jaken31/effente/device/app/README.md

# The effente device app (Arduino UNO Q)

One Arduino App Lab app: the sketch runs on the microcontroller, and the Python side runs our intake, model and stream on the board's Linux side.

```
plug in ──> DISPLAY ──button──> RECORDING ──button──> TRAINING ──done──> WATCHING ──button──> RECORDING ...
            readings              learning              on the board      checking for faults
            ↑ the whole time: readings and status on the OLED, and a live stream on port 8765 ↑
```

| Mode | Screen | What happens |
|---|---|---|
| Streaming | `STREAMING` and the time, vibration, peak, speed, temperature | Sensors are read and features computed; nothing is kept |
| Recording | `RECORDING` and the readings | Learn mode: feature rows, per-minute summaries, raw snippets and events go to `data/recordings/rec-…` |
| Training | `TRAINING`, then the percentage and stage | The model is trained on the board ([effente/trainer.py](../../effente/trainer.py), NumPy only). A recording shorter than 5 minutes is refused, and learning carries on. A day or more trains from the per-minute summaries, so a week fits in memory |
| Inference | `NOTHING WRONG`, or what is wrong (`UNBALANCE LIKE`, `OUTSIDE NORMAL`, …) and the reading that moved most | Judges every summary period: 1 s after a short recording, up to a minute after a long one |

Pressing the button while in inference starts a new recording, to relearn. Recording happens only in the recording mode, and only a button press starts it. After a power cut:

- **Inference:** it carries on with the saved model.
- **Training:** it carries on training. If training then fails, it goes back to not recording, not to recording.
- **Recording:** the recording stops. What was kept stays in its folder, and the app comes back not recording: inference with the saved model if there is one, otherwise streaming. The status message says `power cut ended the recording; press to record again`. The next press starts a new recording.

## What counts as wrong

The device answers two things only: is something wrong, and what. There are no severity levels. "What" is a plain description of what is going on (VIBRATION TOO HIGH, UNUSUAL VIBRATION, KNOCKING OR JOLTS, RAPID TEMP CHANGES, …), not a guess at the cause. The description comes straight from which groups of readings left normal (vibration level, vibration shape, spikiness, speed, temperature, sound, …). On 20 real bearings, the cause guesses were mostly wrong, but the descriptions were accurate for all 35 faults caught ([OTTAWA_RESULTS.md](../../training/record/datasets/OTTAWA_RESULTS.md)). The specific fault type still goes out in the data (`details`, `diagnosis`) for the team. Problems show on the screen as `! …` lines in every mode, go out on the stream as `problem` and `problem_cleared` events, and appear in `/latest` status as `wrong`, `what` and `problems`. The rules are in [effente/safety.py](../../effente/safety.py).

- **The sensor itself, first:** `SENSOR PROBLEM` when the readings make no sense. That means gravity far from 1 g (outside 0.85–1.15 g), no noise at all on any axis (stuck or disconnected), or an IMU temperature outside its rated −40 to 125 °C. While it's on, the vibration checks and the model's diagnosis are set aside, because they would only be judging bad data. On 12 Nov, corrupted samples made the device say VIBRATION TOO HIGH while it sat still; now that case says SENSOR PROBLEM. Learning on such data gives a training note. Sensors that remove gravity by design (industrial piezo sensors) skip the gravity test: their data source sets `accel_measures_gravity = False`.
- **From the moment it's plugged in (no setup, any machine):**
  - vibration over 11 mm/s
  - knocking: impulsive vibration with peaks of 0.5 g or more
  - over 100 °C
  - heating more than 8 °C a minute
  - 5 or more sudden jolts in 10 minutes
- **After training, against this machine's own normal** (the highest while learning): vibration at 2× normal, 15 °C or 6 dB over normal, and the learned model's line. No one has to say what kind of machine it is.
- Each check must hold for 10 seconds before it shows, so a bump doesn't count.
- **Notes after training:** the screen shows notes for 2 minutes after training (status keeps them) if the machine was mostly stopped, hardly vibrated, or was still warming up or changing. Notes also flag a universal limit the machine was already over while learning. That limit is then dropped for this machine, so it doesn't show for ever.

**Sensitivity:** how far outside normal counts as wrong hasn't been decided. Sensitivity goes from 0 (least sensitive) to 1 (most), and the numbers above are the starting values at the default, 0.5. Each 0.25 step halves or doubles how far outside normal counts:

| Sensitivity | Vibration | Temperature | Sound | Model's line |
|---|---|---|---|---|
| 0 | 5× normal | +60 °C | +24 dB | 4× |
| 0.25 | 3× | +30 °C | +12 dB | 2× |
| 0.5 (default) | 2× | +15 °C | +6 dB | 1× |
| 0.75 | 1.5× | +7.5 °C | +3 dB | 0.5× |
| 1 | 1.25× | +3.75 °C | +1.5 dB | 0.25× |

It changes the outside-normal checks and the model, never the universal limits. Change it while the device runs:

```bash
curl -X POST -d '{"sensitivity": 0.7}' http://localhost:8765/settings
```

`curl http://localhost:8765/settings` shows the current value and what it means in numbers. Editing `data/settings.json` on the board (`{"sensitivity": 0.7}`) works too, and is picked up within 2 seconds.

## Early warning

In inference, while nothing is wrong, the device also looks for a small change that has lasted or is creeping up, before it is big enough to count as wrong ([effente/early_warning.py](../../effente/early_warning.py)). It watches each group of readings (the same groups the descriptions come from) and the model's score, against this machine's normal given the other readings, in blocks of 60 summary periods: an hour after a long recording, a minute after a short one. Stopped time is skipped.

- **Screen:** while nothing is wrong, the header's left side reads like `EARLY: HEATING UP` instead of the mode.
- **Stream:** an `early_warning` event (`text`: `TOO HOT CREEPING UP` or `TOO HOT SLIGHTLY UP`, plus `symptom`, `rising` and a coarse `speed`: "rising over hours" or "over days"). An `early_warning_cleared` event follows when it goes away.
- **Status:** `/latest` has an `early_warning` field (`on`, `symptom`, `text`, `since`, …).

It never counts as wrong: `wrong` stays false. While something is wrong it is set aside, it starts again after relearning, and it clears when the change goes away. There's no countdown and no predicted failure time. Sensitivity scales it too. Its normal is saved beside the model (`models/<name>.early.json`). Models trained before it existed have none, so early warning stays off until the machine is relearned. How it compares with other approaches on the simulated conveyor: [EARLY_WARNING.md](../../training/record/conveyor_eval/EARLY_WARNING.md).

## Wiring

| Part | Where | Notes |
|---|---|---|
| MPU6050 (on this board's module: an MPU-6500, WHO_AM_I 0x70) | Third I2C bus (`Wire2`), address 0x68 | Accelerometer ±8 g, gyro ±250 °/s, 1 kHz. Accelerometer low-pass 218 Hz (6500) or 184 Hz (6050) |
| OLED 128×64 | `Wire2`, address 0x3C | SSD1306/SSD1309. For an SH1106, set `OLED_COL_OFFSET` to 2 in the sketch |
| Button | D9 to GND | Internal pull-up, debounced. Until it's wired, `adb shell touch /home/arduino/ArduinoApps/effente/data/press` counts as a press |
| Microphone INMP441, through an ESP32-S3-N16R8 (screen only so far) | Mic to ESP32: VDD 3V3, GND, L/R to GND, SCK GPIO 5, WS GPIO 4, SD GPIO 6. ESP32 to UNO Q: GPIO 17 (TX) to D0, GPIO 18 (RX) to D1 (optional), GND to GND | The ESP32 ([firmware/esp32_mic](../../firmware/esp32_mic/esp32_mic.ino), a test version) sends a text line 4 times a second at 115200 baud: level, peak and a rough strongest tone. On the UNO Q, D0/D1 are `Serial1` (`Serial` is the Bridge's monitor). Measured 13 Nov: 4 lines a second arrive, none missing. The screen shows the level as dBFS + 120 (the datasheet's conversion; not checked against a sound meter, unverified) and the tone. Nothing of it reaches the Linux side as a feature yet: `sound_db` stays empty, and what is sent for sound is still to be agreed by the team. The raw-audio slot is unchanged: the Linux side takes an `audio` notification, but no sketch sends one. Off unless `EFFENTE_MIC=1`. Raw 16 kHz audio won't fit on the Bridge line (see below) |
| Thermal camera MLX90640-D55 (not fitted yet) | I2C, address 0x33, bus not chosen | Slot only: the Linux side takes a `thermal` notification (24 × 32, hundredths of a °C) and the status has `thermal_max_c`, but no sketch reads the camera yet. Off unless `EFFENTE_THERMAL=1` |

## Deploy, and connect to the stream

**Starting at power-up:** on 13 Nov effente was set as the board's default app, so it starts by itself when the board is plugged in:

```bash
adb shell arduino-app-cli properties set default user:effente
```

To stop that, set the default to `none`. Whether it starts reliably at every power-up is untested.

From the repo root, with the board on USB:

```bash
device/app/deploy.sh
```

```bash
adb forward tcp:8765 tcp:8765
```

```bash
curl -N http://localhost:8765/stream
```

`/settings` is described above. `/latest`, `/features` and `/health` are described in [device/intake/README.md](../intake/README.md). On a network that lets devices see each other, use the board's address instead of `localhost`. University WiFi usually doesn't allow that, so use the USB forward or a phone hotspot.

Data stays on the board in `~/ArduinoApps/effente/data`: `recordings/`, `models/`, `state.json`, `settings.json` and `history.npz`. The deploy script never touches it.

## The fan test

This tests the whole device. Fix it to a desk fan and let it learn the fan's normal. Then tape a coin to one blade and see whether it says something is wrong and describes it as a vibration problem. [fan_test.py](fan_test.py) runs on the laptop and guides you through it.

You need:

- the board on USB, with the app deployed (`device/app/deploy.sh`)
- a desk fan
- a coin and some tape
- about 45 minutes

```bash
python3 device/app/fan_test.py
```

The script sets up `adb forward tcp:8765 tcp:8765` itself, then:

1. checks the app is up (`/health`, `/latest`) and prints the sensitivity (`GET /settings`)
2. asks you to fix the device to the fan and switch it on, then presses the button (`adb shell touch …/data/press`) to start learning
3. waits `--minutes` (default 20), showing how long it has learned. Leave the fan running.
4. presses again to train and shows training progress until the device is in inference
5. watches `--normal-minutes` (default 10) with the fan as it is. Anything wrong now is a false alarm.
6. asks you to switch the fan off, tape the coin near the tip of one blade and switch it back on. It then watches up to `--fault-minutes` (default 10). It reports whether the device said something is wrong, what it named, and how long that took. It stops 30 s (`--settle`) after the vibration is described.
7. optionally tries another sensitivity with the coin still on: `--try-sensitivity 0.7`, or type a value when asked. It watches for `--sensitivity-minutes` (default 5), then puts the old sensitivity back.
8. writes a JSON report to `data/fan-test-<time>.json`. Like all of `data/`, it is never committed.

The test passes if there were no false alarms and the coin was described as UNUSUAL VIBRATION or VIBRATION TOO HIGH (`unusual_vibration` or `vibration_too_high` in `what`). The report also says whether the guessed cause was unbalance (`unbalance_like` in `details` or `diagnosis_detail`, which the platform contract calls `imbalance`), for information only. "Wrong" is the device's own `wrong`, in a results line or in status. It covers the model and the no-setup limits (vibration over 11 mm/s, …), so a false alarm from either counts. The exit code is 0 for a pass and 1 otherwise.

Other options:

- `--url` for a board reached over the network, with `--no-forward`
- `--press-cmd "…"` for another way to press the button
- `--poll` for how often status is checked
- `--yes` to skip the Enter prompts

It is tested without hardware, against a local `DeviceApp` fed simulated conveyor data (`python3 -m device.intake.tests.test_fan_test`). **It hasn't been run on the board or a real fan yet.**

## Send to the laptop platform

Set `EFFENTE_PLATFORM_URL` in the app's environment to the laptop's address on the hotspot, for example `http://192.168.43.10:8000` (`python3 platform/run.py --no-sim` prints it). The app then sends its model, a record a second while in inference, and a check-in otherwise, as in [platform/CONTRACT.md](../../platform/CONTRACT.md). Unset, nothing is sent. The start-up line in the app's log says which. Details are in [device/intake/README.md](../intake/README.md#sending-to-the-laptop-platform).

How App Lab passes environment variables to the Python side hasn't been tried yet, and neither has uploading from the board itself.

## Measured on this board (12 Nov 2026)

| | |
|--|--|
| Sample rate | 1,000 a second (998–1,002 by the microcontroller's clock), 0 lost, 0 FIFO overflows |
| Bridge line | 115200 baud, about 11.5 kB/s. The sensor stream uses 7.5 kB/s (65 %). At 1,445 samples a second (the MPU-6500's rate with the old settings) the line was full, and the router logged corrupted packets |
| At rest | 1.018 g; noise 4–9 mg rms (the MPU's own noise) |
| IMU temperature | About 28 °C on a desk (13 Nov), from the IMU's own temperature sensor, sent with every batch, and used as the heat reading when there's no thermal camera. Until 13 Nov it read about 43 °C, because the MPU-6050's conversion was used for our MPU-6500. The 6500's is raw / 333.87 + 21 |
| Features per window | 29 ms with every sensor (12 % of one core at 4 windows a second); less with only the IMU |
| Model | Loads in 8 ms, judges in 6 ms |
| OLED | 10 frames a second, drawn one eighth of the screen per pass at 400 kHz. Drawing the whole frame at once held the bus for about 27 ms; with the sensor read on top, that overflowed the MPU-6500's 512-byte FIFO, which corrupted every later sample (2 g of "vibration" at rest). Running the bus at 1 MHz didn't help. Text from the Linux side costs about 180 bytes of Bridge line per update |
| After the fix (12 Nov, after the reflash) | At rest: 1.018 g gravity, 2–4 mg noise per axis, 0.3–0.5 mm/s. About one FIFO restart every 5 s remains (about 0.7 % of samples, rate 993 a second); the cause isn't found yet |

## Limits and known issues

- **What the Bridge can carry:** the accelerometer at 1 kHz plus the gyro at 100 Hz fits. The microphone (16 kHz) and the thermal camera won't fit raw on the 115200-baud line. Options:
  - process them on the microcontroller
  - connect the mic to the Linux side
  - raise the router's baud rate (a system service change that needs `sudo`; untested)
- **After reflashing the board:** check `systemctl status arduino-burn-bootloader`. On 12 Nov its first-boot run timed out, so the sketch never started (0 samples). Running `arduino-cli burn-bootloader -b arduino:zephyr:unoq -P jlink` on the board fixed it. The newer toolchain also no longer links `log10f` (missing `__errno`), so the sketch uses its own.
- **Startup:** now and then, when the app starts, the sketch doesn't start on the microcontroller: no samples, and the screen frozen. Starting the app again has always fixed it. `deploy.sh` now waits for samples after each start and retries up to 3 times by itself; if all 3 fail, unplug the board for a few seconds. To tell what state it's in, the sketch sends a heartbeat each second: alive, sensor and screen found, WHO_AM_I, and the bus lines' levels. The app logs it every 10 s as `microcontroller: ...`, and "no heartbeat yet" means the sketch isn't running. At every start the sketch also frees the I2C bus (clock pulses on A5, then a STOP), in case a reset caught the sensor or screen mid-reply. It retries a missing sensor or screen every 2 s and shows SENSOR NOT FOUND meanwhile.
- **A sensor that resets while running:** on 13 Nov a loose clock wire (A5) glitched the bus 35 s in. The MPU came back in its power-on state (asleep, FIFO off): it still answered, so it counted as found, but no samples came, for good. The sketch now sets the sensor up again when no sample has arrived for half a second. It compiles and runs on the board, but hasn't been tried against a real glitch yet (unverified).
- **Ownership:** the sketch belongs in `firmware/` and the app in `device/`, which is track 1's area under AGENTS.md. It's here as track 2's sensor app, until track 1's work replaces it.
