jaken31/effente/training/validation/REPORT.md

# Validation report

Written by `python3 -m training.validation.report` from the files in `results/`. Do not edit by hand: rerun `python3 -m training.validation.run_all`.

- Label `simulated`: the data comes from the repo's simulators. `public`: a public dataset. `unverified`: the row depends on the fault type signatures, which have not been checked on real faults.
- Stand-in: `no`, or what stands in for code or a rule that does not exist yet. A row with a stand-in must be rerun when the real thing lands.
- A period is one summary period of the model; its length is in the n column.
- No row comes from a device recording. What to rerun once recordings exist: [RERUN.md](RERUN.md).

Library and calibration code under test: training/library/entries (track 3) calibrated by effente.calibration.calibrate (track 3).

| Check | Entry | Metric | Value | n | Lowest to highest over seeds | Command | Seeds | Data source | Label | Stand-in |
|---|---|---|---|---|---|---|---|---|---|---|
| 1. Held-out normal data after calibration | conveyor | share of periods that alarm, the 30 min after calibration, same session | 0.0 | 8995 periods of 1 s, 5 machines | 0 to 0 | `python3 -m training.validation.check_heldout_normal --seeds 1,2,3,4,5` | 1,2,3,4,5 | effente.simulate_conveyor (realistic mode) + effente.site_noise (factory) | simulated | no |
| 1. Held-out normal data after calibration | conveyor | share of periods that alarm, a later 30 min session, history restarted | 0.0292 | 8995 periods of 1 s, 5 machines | 0 to 0.1462 | `python3 -m training.validation.check_heldout_normal --seeds 1,2,3,4,5` | 1,2,3,4,5 | effente.simulate_conveyor (realistic mode) + effente.site_noise (factory) | simulated | no |
| 1. Held-out normal data after calibration | generic_rotating | share of periods that alarm, the 30 min after calibration, same session | 0.0 | 8995 periods of 1 s, 5 machines | 0 to 0 | `python3 -m training.validation.check_heldout_normal --seeds 1,2,3,4,5` | 1,2,3,4,5 | effente.simulate_server + effente.site_noise (datacenter) | simulated | no |
| 1. Held-out normal data after calibration | generic_rotating | share of periods that alarm, a later 30 min session, history restarted | 0.0076 | 8995 periods of 1 s, 5 machines | 0 to 0.03113 | `python3 -m training.validation.check_heldout_normal --seeds 1,2,3,4,5` | 1,2,3,4,5 | effente.simulate_server + effente.site_noise (datacenter) | simulated | no |
| 2. Injected and simulated faults | conveyor | simulated faults, severity 1: share with an alarm after the onset | 0.4545 | 55 faults |  | `python3 -m training.validation.check_faults --seeds 1,2,3,4,5` | 1,2,3,4,5 | effente.simulate_conveyor (realistic mode) + effente.site_noise (factory); injected: effente.fault_types signatures on those rows | simulated, unverified | no |
| 2. Injected and simulated faults | conveyor | simulated faults, severity 1: share whose twin without the fault alarms in the same window | 0.0 | 55 faults |  | `python3 -m training.validation.check_faults --seeds 1,2,3,4,5` | 1,2,3,4,5 | effente.simulate_conveyor (realistic mode) + effente.site_noise (factory); injected: effente.fault_types signatures on those rows | simulated, unverified | no |
| 2. Injected and simulated faults | conveyor | simulated faults, severity 1: share with an alarm after the onset, faults whose twin does not alarm | 0.4545 | 55 faults |  | `python3 -m training.validation.check_faults --seeds 1,2,3,4,5` | 1,2,3,4,5 | effente.simulate_conveyor (realistic mode) + effente.site_noise (factory); injected: effente.fault_types signatures on those rows | simulated, unverified | no |
| 2. Injected and simulated faults | conveyor | simulated faults, severity 1: median seconds from onset to first alarm, faults whose twin does not alarm | 11.0 | 25 alarmed of 55 |  | `python3 -m training.validation.check_faults --seeds 1,2,3,4,5` | 1,2,3,4,5 | effente.simulate_conveyor (realistic mode) + effente.site_noise (factory); injected: effente.fault_types signatures on those rows | simulated, unverified | no |
| 2. Injected and simulated faults | conveyor | simulated faults, severity 1: share of alarmed faults given a fault type name (not unrecognised_pattern) | 1.0 | 25 alarmed |  | `python3 -m training.validation.check_faults --seeds 1,2,3,4,5` | 1,2,3,4,5 | effente.simulate_conveyor (realistic mode) + effente.site_noise (factory); injected: effente.fault_types signatures on those rows | simulated, unverified | no |
| 2. Injected and simulated faults | conveyor | simulated faults, severity 1: share of alarmed faults whose screen symptom is one expected for the fault | 0.88 | 25 alarmed |  | `python3 -m training.validation.check_faults --seeds 1,2,3,4,5` | 1,2,3,4,5 | effente.simulate_conveyor (realistic mode) + effente.site_noise (factory); injected: effente.fault_types signatures on those rows | simulated, unverified | no |
| 2. Injected and simulated faults | conveyor | simulated faults, severity 0.3: share with an alarm after the onset | 0.3636 | 55 faults |  | `python3 -m training.validation.check_faults --seeds 1,2,3,4,5` | 1,2,3,4,5 | effente.simulate_conveyor (realistic mode) + effente.site_noise (factory); injected: effente.fault_types signatures on those rows | simulated, unverified | no |
| 2. Injected and simulated faults | conveyor | simulated faults, severity 0.3: share whose twin without the fault alarms in the same window | 0.0 | 55 faults |  | `python3 -m training.validation.check_faults --seeds 1,2,3,4,5` | 1,2,3,4,5 | effente.simulate_conveyor (realistic mode) + effente.site_noise (factory); injected: effente.fault_types signatures on those rows | simulated, unverified | no |
| 2. Injected and simulated faults | conveyor | simulated faults, severity 0.3: share with an alarm after the onset, faults whose twin does not alarm | 0.3636 | 55 faults |  | `python3 -m training.validation.check_faults --seeds 1,2,3,4,5` | 1,2,3,4,5 | effente.simulate_conveyor (realistic mode) + effente.site_noise (factory); injected: effente.fault_types signatures on those rows | simulated, unverified | no |
| 2. Injected and simulated faults | conveyor | simulated faults, severity 0.3: median seconds from onset to first alarm, faults whose twin does not alarm | 29.0 | 20 alarmed of 55 |  | `python3 -m training.validation.check_faults --seeds 1,2,3,4,5` | 1,2,3,4,5 | effente.simulate_conveyor (realistic mode) + effente.site_noise (factory); injected: effente.fault_types signatures on those rows | simulated, unverified | no |
| 2. Injected and simulated faults | conveyor | simulated faults, severity 0.3: share of alarmed faults given a fault type name (not unrecognised_pattern) | 1.0 | 20 alarmed |  | `python3 -m training.validation.check_faults --seeds 1,2,3,4,5` | 1,2,3,4,5 | effente.simulate_conveyor (realistic mode) + effente.site_noise (factory); injected: effente.fault_types signatures on those rows | simulated, unverified | no |
| 2. Injected and simulated faults | conveyor | simulated faults, severity 0.3: share of alarmed faults whose screen symptom is one expected for the fault | 0.8 | 20 alarmed |  | `python3 -m training.validation.check_faults --seeds 1,2,3,4,5` | 1,2,3,4,5 | effente.simulate_conveyor (realistic mode) + effente.site_noise (factory); injected: effente.fault_types signatures on those rows | simulated, unverified | no |
| 2. Injected and simulated faults | conveyor | injected fault types, 8 spreads: share with an alarm after the onset | 0.7273 | 55 faults |  | `python3 -m training.validation.check_faults --seeds 1,2,3,4,5` | 1,2,3,4,5 | effente.simulate_conveyor (realistic mode) + effente.site_noise (factory); injected: effente.fault_types signatures on those rows | simulated, unverified | no |
| 2. Injected and simulated faults | conveyor | injected fault types, 8 spreads: share whose twin without the fault alarms in the same window | 0.0 | 55 faults |  | `python3 -m training.validation.check_faults --seeds 1,2,3,4,5` | 1,2,3,4,5 | effente.simulate_conveyor (realistic mode) + effente.site_noise (factory); injected: effente.fault_types signatures on those rows | simulated, unverified | no |
| 2. Injected and simulated faults | conveyor | injected fault types, 8 spreads: share with an alarm after the onset, faults whose twin does not alarm | 0.7273 | 55 faults |  | `python3 -m training.validation.check_faults --seeds 1,2,3,4,5` | 1,2,3,4,5 | effente.simulate_conveyor (realistic mode) + effente.site_noise (factory); injected: effente.fault_types signatures on those rows | simulated, unverified | no |
| 2. Injected and simulated faults | conveyor | injected fault types, 8 spreads: median seconds from onset to first alarm, faults whose twin does not alarm | 2.0 | 40 alarmed of 55 |  | `python3 -m training.validation.check_faults --seeds 1,2,3,4,5` | 1,2,3,4,5 | effente.simulate_conveyor (realistic mode) + effente.site_noise (factory); injected: effente.fault_types signatures on those rows | simulated, unverified | no |
| 2. Injected and simulated faults | conveyor | injected fault types, 8 spreads: share of alarmed faults given a fault type name (not unrecognised_pattern) | 1.0 | 40 alarmed |  | `python3 -m training.validation.check_faults --seeds 1,2,3,4,5` | 1,2,3,4,5 | effente.simulate_conveyor (realistic mode) + effente.site_noise (factory); injected: effente.fault_types signatures on those rows | simulated, unverified | no |
| 2. Injected and simulated faults | conveyor | injected fault types, 8 spreads: share of alarmed faults named as the injected type | 1.0 | 40 alarmed |  | `python3 -m training.validation.check_faults --seeds 1,2,3,4,5` | 1,2,3,4,5 | effente.simulate_conveyor (realistic mode) + effente.site_noise (factory); injected: effente.fault_types signatures on those rows | simulated, unverified | no |
| 2. Injected and simulated faults | generic_rotating | simulated faults, severity 1: share with an alarm after the onset | 0.25 | 20 faults |  | `python3 -m training.validation.check_faults --seeds 1,2,3,4,5` | 1,2,3,4,5 | effente.simulate_server + effente.site_noise (datacenter); injected: effente.fault_types signatures on those rows | simulated, unverified | no |
| 2. Injected and simulated faults | generic_rotating | simulated faults, severity 1: share whose twin without the fault alarms in the same window | 0.0 | 20 faults |  | `python3 -m training.validation.check_faults --seeds 1,2,3,4,5` | 1,2,3,4,5 | effente.simulate_server + effente.site_noise (datacenter); injected: effente.fault_types signatures on those rows | simulated, unverified | no |
| 2. Injected and simulated faults | generic_rotating | simulated faults, severity 1: share with an alarm after the onset, faults whose twin does not alarm | 0.25 | 20 faults |  | `python3 -m training.validation.check_faults --seeds 1,2,3,4,5` | 1,2,3,4,5 | effente.simulate_server + effente.site_noise (datacenter); injected: effente.fault_types signatures on those rows | simulated, unverified | no |
| 2. Injected and simulated faults | generic_rotating | simulated faults, severity 1: median seconds from onset to first alarm, faults whose twin does not alarm | 2.0 | 5 alarmed of 20 |  | `python3 -m training.validation.check_faults --seeds 1,2,3,4,5` | 1,2,3,4,5 | effente.simulate_server + effente.site_noise (datacenter); injected: effente.fault_types signatures on those rows | simulated, unverified | no |
| 2. Injected and simulated faults | generic_rotating | simulated faults, severity 1: share of alarmed faults given a fault type name (not unrecognised_pattern) | 1.0 | 5 alarmed |  | `python3 -m training.validation.check_faults --seeds 1,2,3,4,5` | 1,2,3,4,5 | effente.simulate_server + effente.site_noise (datacenter); injected: effente.fault_types signatures on those rows | simulated, unverified | no |
| 2. Injected and simulated faults | generic_rotating | injected fault types, 8 spreads: share with an alarm after the onset | 0.3 | 50 faults |  | `python3 -m training.validation.check_faults --seeds 1,2,3,4,5` | 1,2,3,4,5 | effente.simulate_server + effente.site_noise (datacenter); injected: effente.fault_types signatures on those rows | simulated, unverified | no |
| 2. Injected and simulated faults | generic_rotating | injected fault types, 8 spreads: share whose twin without the fault alarms in the same window | 0.0 | 50 faults |  | `python3 -m training.validation.check_faults --seeds 1,2,3,4,5` | 1,2,3,4,5 | effente.simulate_server + effente.site_noise (datacenter); injected: effente.fault_types signatures on those rows | simulated, unverified | no |
| 2. Injected and simulated faults | generic_rotating | injected fault types, 8 spreads: share with an alarm after the onset, faults whose twin does not alarm | 0.3 | 50 faults |  | `python3 -m training.validation.check_faults --seeds 1,2,3,4,5` | 1,2,3,4,5 | effente.simulate_server + effente.site_noise (datacenter); injected: effente.fault_types signatures on those rows | simulated, unverified | no |
| 2. Injected and simulated faults | generic_rotating | injected fault types, 8 spreads: median seconds from onset to first alarm, faults whose twin does not alarm | 2.0 | 15 alarmed of 50 |  | `python3 -m training.validation.check_faults --seeds 1,2,3,4,5` | 1,2,3,4,5 | effente.simulate_server + effente.site_noise (datacenter); injected: effente.fault_types signatures on those rows | simulated, unverified | no |
| 2. Injected and simulated faults | generic_rotating | injected fault types, 8 spreads: share of alarmed faults given a fault type name (not unrecognised_pattern) | 1.0 | 15 alarmed |  | `python3 -m training.validation.check_faults --seeds 1,2,3,4,5` | 1,2,3,4,5 | effente.simulate_server + effente.site_noise (datacenter); injected: effente.fault_types signatures on those rows | simulated, unverified | no |
| 2. Injected and simulated faults | generic_rotating | injected fault types, 8 spreads: share of alarmed faults named as the injected type | 1.0 | 15 alarmed |  | `python3 -m training.validation.check_faults --seeds 1,2,3,4,5` | 1,2,3,4,5 | effente.simulate_server + effente.site_noise (datacenter); injected: effente.fault_types signatures on those rows | simulated, unverified | no |
| 3. A fault no type covers | conveyor | uncovered patterns: share with an alarm after the onset | 1.0 | 10 patterns |  | `python3 -m training.validation.check_unknown_fault --seeds 1,2,3,4,5` | 1,2,3,4,5 | effente.simulate_conveyor (realistic mode) + effente.site_noise (factory); injected: readings in no fault type signature | simulated, unverified | no |
| 3. A fault no type covers | conveyor | uncovered patterns: share whose twin without the pattern alarms in the same window | 0.0 | 10 patterns |  | `python3 -m training.validation.check_unknown_fault --seeds 1,2,3,4,5` | 1,2,3,4,5 | effente.simulate_conveyor (realistic mode) + effente.site_noise (factory); injected: readings in no fault type signature | simulated, unverified | no |
| 3. A fault no type covers | conveyor | uncovered patterns: share of alarmed ones shown as unrecognised_pattern on the screen | 0.6 | 10 alarmed |  | `python3 -m training.validation.check_unknown_fault --seeds 1,2,3,4,5` | 1,2,3,4,5 | effente.simulate_conveyor (realistic mode) + effente.site_noise (factory); injected: readings in no fault type signature | simulated, unverified | no |
| 3. A fault no type covers | conveyor | uncovered patterns: share of alarm periods that are unrecognised_pattern | 0.8767 | 5970 alarm periods |  | `python3 -m training.validation.check_unknown_fault --seeds 1,2,3,4,5` | 1,2,3,4,5 | effente.simulate_conveyor (realistic mode) + effente.site_noise (factory); injected: readings in no fault type signature | simulated, unverified | no |
| 3. A fault no type covers | generic_rotating | uncovered patterns: share with an alarm after the onset | 1.0 | 10 patterns |  | `python3 -m training.validation.check_unknown_fault --seeds 1,2,3,4,5` | 1,2,3,4,5 | effente.simulate_server + effente.site_noise (datacenter); injected: readings in no fault type signature | simulated, unverified | no |
| 3. A fault no type covers | generic_rotating | uncovered patterns: share whose twin without the pattern alarms in the same window | 0.0 | 10 patterns |  | `python3 -m training.validation.check_unknown_fault --seeds 1,2,3,4,5` | 1,2,3,4,5 | effente.simulate_server + effente.site_noise (datacenter); injected: readings in no fault type signature | simulated, unverified | no |
| 3. A fault no type covers | generic_rotating | uncovered patterns: share of alarmed ones shown as unrecognised_pattern on the screen | 0.5 | 10 alarmed |  | `python3 -m training.validation.check_unknown_fault --seeds 1,2,3,4,5` | 1,2,3,4,5 | effente.simulate_server + effente.site_noise (datacenter); injected: readings in no fault type signature | simulated, unverified | no |
| 3. A fault no type covers | generic_rotating | uncovered patterns: share of alarm periods that are unrecognised_pattern | 0.8666 | 5748 alarm periods |  | `python3 -m training.validation.check_unknown_fault --seeds 1,2,3,4,5` | 1,2,3,4,5 | effente.simulate_server + effente.site_noise (datacenter); injected: readings in no fault type signature | simulated, unverified | no |
| 4. int8 runtime vs trained network | conveyor | int8 vs float score correlation, the entry's network | 0.99997 | 1 model |  | `python3 -m training.validation.check_int8 --seeds 1,2,3,4,5` | 1,2,3,4,5 | training/library | simulated | no |
| 4. int8 runtime vs trained network | generic_rotating | int8 vs float score correlation, the entry's network | 0.99999 | 1 model |  | `python3 -m training.validation.check_int8 --seeds 1,2,3,4,5` | 1,2,3,4,5 | training/library | simulated | no |
| 4. int8 runtime vs trained network | own model, conveyor | int8 vs float score correlation, lowest over machines | 0.99993 | 5 models | 0.9999 to 1 | `python3 -m training.validation.check_int8 --seeds 1,2,3,4,5` | 1,2,3,4,5 | effente.simulate_conveyor (realistic mode) + effente.site_noise (factory) | simulated | no |
| 4. int8 runtime vs trained network | own model, server | int8 vs float score correlation, lowest over machines | 0.99996 | 5 models | 1 to 1 | `python3 -m training.validation.check_int8 --seeds 1,2,3,4,5` | 1,2,3,4,5 | effente.simulate_server + effente.site_noise (datacenter) | simulated | no |
| 5. Calibration length | conveyor | 300 s calibration: share of held-out normal periods that alarm | 0.0 | 8995 periods of 1 s, 5 machines | 0 to 0 | `python3 -m training.validation.check_calibration_length --seeds 1,2,3,4,5` | 1,2,3,4,5 | effente.simulate_conveyor (realistic mode) + effente.site_noise (factory) | simulated | no |
| 5. Calibration length | conveyor | 300 s calibration: share of simulated faults with no alarm after the onset | 0.5909 | 110 faults |  | `python3 -m training.validation.check_calibration_length --seeds 1,2,3,4,5` | 1,2,3,4,5 | effente.simulate_conveyor (realistic mode) + effente.site_noise (factory) | simulated | no |
| 5. Calibration length | conveyor | 300 s calibration: share of the faults' no-fault twins that alarm in the fault window | 0.0 | 5 machines |  | `python3 -m training.validation.check_calibration_length --seeds 1,2,3,4,5` | 1,2,3,4,5 | effente.simulate_conveyor (realistic mode) + effente.site_noise (factory) | simulated | no |
| 5. Calibration length | conveyor | 240 s calibration: share of held-out normal periods that alarm | 0.0 | 8995 periods of 1 s, 5 machines | 0 to 0 | `python3 -m training.validation.check_calibration_length --seeds 1,2,3,4,5` | 1,2,3,4,5 | effente.simulate_conveyor (realistic mode) + effente.site_noise (factory) | simulated | no |
| 5. Calibration length | conveyor | 240 s calibration: share of simulated faults with no alarm after the onset | 0.5909 | 110 faults |  | `python3 -m training.validation.check_calibration_length --seeds 1,2,3,4,5` | 1,2,3,4,5 | effente.simulate_conveyor (realistic mode) + effente.site_noise (factory) | simulated | no |
| 5. Calibration length | conveyor | 240 s calibration: share of the faults' no-fault twins that alarm in the fault window | 0.0 | 5 machines |  | `python3 -m training.validation.check_calibration_length --seeds 1,2,3,4,5` | 1,2,3,4,5 | effente.simulate_conveyor (realistic mode) + effente.site_noise (factory) | simulated | no |
| 5. Calibration length | conveyor | 180 s calibration: share of held-out normal periods that alarm | 0.0 | 8995 periods of 1 s, 5 machines | 0 to 0 | `python3 -m training.validation.check_calibration_length --seeds 1,2,3,4,5` | 1,2,3,4,5 | effente.simulate_conveyor (realistic mode) + effente.site_noise (factory) | simulated | no |
| 5. Calibration length | conveyor | 180 s calibration: share of simulated faults with no alarm after the onset | 0.5909 | 110 faults |  | `python3 -m training.validation.check_calibration_length --seeds 1,2,3,4,5` | 1,2,3,4,5 | effente.simulate_conveyor (realistic mode) + effente.site_noise (factory) | simulated | no |
| 5. Calibration length | conveyor | 180 s calibration: share of the faults' no-fault twins that alarm in the fault window | 0.0 | 5 machines |  | `python3 -m training.validation.check_calibration_length --seeds 1,2,3,4,5` | 1,2,3,4,5 | effente.simulate_conveyor (realistic mode) + effente.site_noise (factory) | simulated | no |
| 5. Calibration length | conveyor | 120 s calibration: share of held-out normal periods that alarm | 0.0 | 8995 periods of 1 s, 5 machines | 0 to 0 | `python3 -m training.validation.check_calibration_length --seeds 1,2,3,4,5` | 1,2,3,4,5 | effente.simulate_conveyor (realistic mode) + effente.site_noise (factory) | simulated | no |
| 5. Calibration length | conveyor | 120 s calibration: share of simulated faults with no alarm after the onset | 0.5909 | 110 faults |  | `python3 -m training.validation.check_calibration_length --seeds 1,2,3,4,5` | 1,2,3,4,5 | effente.simulate_conveyor (realistic mode) + effente.site_noise (factory) | simulated | no |
| 5. Calibration length | conveyor | 120 s calibration: share of the faults' no-fault twins that alarm in the fault window | 0.0 | 5 machines |  | `python3 -m training.validation.check_calibration_length --seeds 1,2,3,4,5` | 1,2,3,4,5 | effente.simulate_conveyor (realistic mode) + effente.site_noise (factory) | simulated | no |
| 5. Calibration length | conveyor | 60 s calibration: share of held-out normal periods that alarm | 0.0 | 8995 periods of 1 s, 5 machines | 0 to 0 | `python3 -m training.validation.check_calibration_length --seeds 1,2,3,4,5` | 1,2,3,4,5 | effente.simulate_conveyor (realistic mode) + effente.site_noise (factory) | simulated | no |
| 5. Calibration length | conveyor | 60 s calibration: share of simulated faults with no alarm after the onset | 0.5818 | 110 faults |  | `python3 -m training.validation.check_calibration_length --seeds 1,2,3,4,5` | 1,2,3,4,5 | effente.simulate_conveyor (realistic mode) + effente.site_noise (factory) | simulated | no |
| 5. Calibration length | conveyor | 60 s calibration: share of the faults' no-fault twins that alarm in the fault window | 0.0 | 5 machines |  | `python3 -m training.validation.check_calibration_length --seeds 1,2,3,4,5` | 1,2,3,4,5 | effente.simulate_conveyor (realistic mode) + effente.site_noise (factory) | simulated | no |
| 5. Calibration length | conveyor | 30 s calibration: calibrations the calibration code refused | 10 | 5 machines |  | `python3 -m training.validation.check_calibration_length --seeds 1,2,3,4,5` | 1,2,3,4,5 | effente.simulate_conveyor (realistic mode) + effente.site_noise (factory) | simulated | no |
| 5. Calibration length | generic_rotating | 300 s calibration: share of held-out normal periods that alarm | 0.0 | 8995 periods of 1 s, 5 machines | 0 to 0 | `python3 -m training.validation.check_calibration_length --seeds 1,2,3,4,5` | 1,2,3,4,5 | effente.simulate_server + effente.site_noise (datacenter) | simulated | no |
| 5. Calibration length | generic_rotating | 300 s calibration: share of simulated faults with no alarm after the onset | 0.75 | 20 faults |  | `python3 -m training.validation.check_calibration_length --seeds 1,2,3,4,5` | 1,2,3,4,5 | effente.simulate_server + effente.site_noise (datacenter) | simulated | no |
| 5. Calibration length | generic_rotating | 300 s calibration: share of the faults' no-fault twins that alarm in the fault window | 0.0 | 5 machines |  | `python3 -m training.validation.check_calibration_length --seeds 1,2,3,4,5` | 1,2,3,4,5 | effente.simulate_server + effente.site_noise (datacenter) | simulated | no |
| 5. Calibration length | generic_rotating | 240 s calibration: share of held-out normal periods that alarm | 0.0 | 8995 periods of 1 s, 5 machines | 0 to 0 | `python3 -m training.validation.check_calibration_length --seeds 1,2,3,4,5` | 1,2,3,4,5 | effente.simulate_server + effente.site_noise (datacenter) | simulated | no |
| 5. Calibration length | generic_rotating | 240 s calibration: share of simulated faults with no alarm after the onset | 0.75 | 20 faults |  | `python3 -m training.validation.check_calibration_length --seeds 1,2,3,4,5` | 1,2,3,4,5 | effente.simulate_server + effente.site_noise (datacenter) | simulated | no |
| 5. Calibration length | generic_rotating | 240 s calibration: share of the faults' no-fault twins that alarm in the fault window | 0.0 | 5 machines |  | `python3 -m training.validation.check_calibration_length --seeds 1,2,3,4,5` | 1,2,3,4,5 | effente.simulate_server + effente.site_noise (datacenter) | simulated | no |
| 5. Calibration length | generic_rotating | 180 s calibration: share of held-out normal periods that alarm | 0.0 | 8995 periods of 1 s, 5 machines | 0 to 0 | `python3 -m training.validation.check_calibration_length --seeds 1,2,3,4,5` | 1,2,3,4,5 | effente.simulate_server + effente.site_noise (datacenter) | simulated | no |
| 5. Calibration length | generic_rotating | 180 s calibration: share of simulated faults with no alarm after the onset | 0.75 | 20 faults |  | `python3 -m training.validation.check_calibration_length --seeds 1,2,3,4,5` | 1,2,3,4,5 | effente.simulate_server + effente.site_noise (datacenter) | simulated | no |
| 5. Calibration length | generic_rotating | 180 s calibration: share of the faults' no-fault twins that alarm in the fault window | 0.0 | 5 machines |  | `python3 -m training.validation.check_calibration_length --seeds 1,2,3,4,5` | 1,2,3,4,5 | effente.simulate_server + effente.site_noise (datacenter) | simulated | no |
| 5. Calibration length | generic_rotating | 120 s calibration: share of held-out normal periods that alarm | 0.0 | 8995 periods of 1 s, 5 machines | 0 to 0 | `python3 -m training.validation.check_calibration_length --seeds 1,2,3,4,5` | 1,2,3,4,5 | effente.simulate_server + effente.site_noise (datacenter) | simulated | no |
| 5. Calibration length | generic_rotating | 120 s calibration: share of simulated faults with no alarm after the onset | 0.75 | 20 faults |  | `python3 -m training.validation.check_calibration_length --seeds 1,2,3,4,5` | 1,2,3,4,5 | effente.simulate_server + effente.site_noise (datacenter) | simulated | no |
| 5. Calibration length | generic_rotating | 120 s calibration: share of the faults' no-fault twins that alarm in the fault window | 0.0 | 5 machines |  | `python3 -m training.validation.check_calibration_length --seeds 1,2,3,4,5` | 1,2,3,4,5 | effente.simulate_server + effente.site_noise (datacenter) | simulated | no |
| 5. Calibration length | generic_rotating | 60 s calibration: share of held-out normal periods that alarm | 0.01 | 8995 periods of 1 s, 5 machines | 0 to 0.05003 | `python3 -m training.validation.check_calibration_length --seeds 1,2,3,4,5` | 1,2,3,4,5 | effente.simulate_server + effente.site_noise (datacenter) | simulated | no |
| 5. Calibration length | generic_rotating | 60 s calibration: share of simulated faults with no alarm after the onset | 0.6 | 20 faults |  | `python3 -m training.validation.check_calibration_length --seeds 1,2,3,4,5` | 1,2,3,4,5 | effente.simulate_server + effente.site_noise (datacenter) | simulated | no |
| 5. Calibration length | generic_rotating | 60 s calibration: share of the faults' no-fault twins that alarm in the fault window | 0.2 | 5 machines |  | `python3 -m training.validation.check_calibration_length --seeds 1,2,3,4,5` | 1,2,3,4,5 | effente.simulate_server + effente.site_noise (datacenter) | simulated | no |
| 5. Calibration length | generic_rotating | 30 s calibration: calibrations the calibration code refused | 10 | 5 machines |  | `python3 -m training.validation.check_calibration_length --seeds 1,2,3,4,5` | 1,2,3,4,5 | effente.simulate_server + effente.site_noise (datacenter) | simulated | no |
| 6. Fit check | conveyor | fit check, conveyor machines (right entry): share that pass | 1.0 | 5 machines |  | `python3 -m training.validation.check_fit --seeds 1,2,3,4,5` | 1,2,3,4,5 | effente.simulate_conveyor (realistic mode) + effente.site_noise (factory); effente.simulate_server + effente.site_noise (datacenter) | simulated | track 3's starting rule (effente.calibration.FIT_MAX_RATIO = 3), set on the simulators only; the TRD leaves the rule open |
| 6. Fit check | conveyor | fit check, conveyor machines (right entry): median held-out score after calibration over the entry's own held-out median score, median over machines | 0.3103 | 5 machines | 0.2966 to 0.3883 | `python3 -m training.validation.check_fit --seeds 1,2,3,4,5` | 1,2,3,4,5 | effente.simulate_conveyor (realistic mode) + effente.site_noise (factory); effente.simulate_server + effente.site_noise (datacenter) | simulated | no |
| 6. Fit check | conveyor | fit check, conveyor machines (right entry): median calibration score on the entry as shipped over the entry's threshold, median over machines | 0.071 | 5 machines | 0.0451 to 0.1153 | `python3 -m training.validation.check_fit --seeds 1,2,3,4,5` | 1,2,3,4,5 | effente.simulate_conveyor (realistic mode) + effente.site_noise (factory); effente.simulate_server + effente.site_noise (datacenter) | simulated | no |
| 6. Fit check | conveyor | fit check, server machines (wrong entry): share that fail | 0.0 | 5 machines |  | `python3 -m training.validation.check_fit --seeds 1,2,3,4,5` | 1,2,3,4,5 | effente.simulate_conveyor (realistic mode) + effente.site_noise (factory); effente.simulate_server + effente.site_noise (datacenter) | simulated | track 3's starting rule (effente.calibration.FIT_MAX_RATIO = 3), set on the simulators only; the TRD leaves the rule open |
| 6. Fit check | conveyor | fit check, server machines (wrong entry): median held-out score after calibration over the entry's own held-out median score, median over machines | 0.7092 | 5 machines | 0.4991 to 0.8142 | `python3 -m training.validation.check_fit --seeds 1,2,3,4,5` | 1,2,3,4,5 | effente.simulate_conveyor (realistic mode) + effente.site_noise (factory); effente.simulate_server + effente.site_noise (datacenter) | simulated | no |
| 6. Fit check | conveyor | fit check, server machines (wrong entry): median calibration score on the entry as shipped over the entry's threshold, median over machines | 1.1052 | 5 machines | 1.072 to 1.128 | `python3 -m training.validation.check_fit --seeds 1,2,3,4,5` | 1,2,3,4,5 | effente.simulate_conveyor (realistic mode) + effente.site_noise (factory); effente.simulate_server + effente.site_noise (datacenter) | simulated | no |
| 6. Fit check | generic_rotating | fit check, conveyor machines (neither right nor wrong): share that pass | 1.0 | 5 machines |  | `python3 -m training.validation.check_fit --seeds 1,2,3,4,5` | 1,2,3,4,5 | effente.simulate_conveyor (realistic mode) + effente.site_noise (factory); effente.simulate_server + effente.site_noise (datacenter) | simulated | track 3's starting rule (effente.calibration.FIT_MAX_RATIO = 3), set on the simulators only; the TRD leaves the rule open |
| 6. Fit check | generic_rotating | fit check, conveyor machines (neither right nor wrong): median held-out score after calibration over the entry's own held-out median score, median over machines | 0.1006 | 5 machines | 0.0964 to 0.1111 | `python3 -m training.validation.check_fit --seeds 1,2,3,4,5` | 1,2,3,4,5 | effente.simulate_conveyor (realistic mode) + effente.site_noise (factory); effente.simulate_server + effente.site_noise (datacenter) | simulated | no |
| 6. Fit check | generic_rotating | fit check, conveyor machines (neither right nor wrong): median calibration score on the entry as shipped over the entry's threshold, median over machines | 0.1082 | 5 machines | 0.0954 to 0.1743 | `python3 -m training.validation.check_fit --seeds 1,2,3,4,5` | 1,2,3,4,5 | effente.simulate_conveyor (realistic mode) + effente.site_noise (factory); effente.simulate_server + effente.site_noise (datacenter) | simulated | no |
| 6. Fit check | generic_rotating | fit check, server machines (right entry): share that pass | 1.0 | 5 machines |  | `python3 -m training.validation.check_fit --seeds 1,2,3,4,5` | 1,2,3,4,5 | effente.simulate_conveyor (realistic mode) + effente.site_noise (factory); effente.simulate_server + effente.site_noise (datacenter) | simulated | track 3's starting rule (effente.calibration.FIT_MAX_RATIO = 3), set on the simulators only; the TRD leaves the rule open |
| 6. Fit check | generic_rotating | fit check, server machines (right entry): median held-out score after calibration over the entry's own held-out median score, median over machines | 0.2002 | 5 machines | 0.1404 to 0.2246 | `python3 -m training.validation.check_fit --seeds 1,2,3,4,5` | 1,2,3,4,5 | effente.simulate_conveyor (realistic mode) + effente.site_noise (factory); effente.simulate_server + effente.site_noise (datacenter) | simulated | no |
| 6. Fit check | generic_rotating | fit check, server machines (right entry): median calibration score on the entry as shipped over the entry's threshold, median over machines | 0.6973 | 5 machines | 0.6717 to 0.7455 | `python3 -m training.validation.check_fit --seeds 1,2,3,4,5` | 1,2,3,4,5 | effente.simulate_conveyor (realistic mode) + effente.site_noise (factory); effente.simulate_server + effente.site_noise (datacenter) | simulated | no |
| 7. NASA IMS run to failure, PCA default | run to failure | alarm stretches after learning that ended before the last one began (false alarms) (MPU6050-like conversion) | 0 | 551 snapshots, 91.83 h watched after 72 h of learning |  | `python3 -m training.validation.check_ims --rows training/validation/data/nasa-ims/test2_bearing1.npz --learn-hours 72 --smooth 3` | 0 | NASA IMS bearing data set, test 2, bearing 1 (phm-datasets.s3.amazonaws.com/NASA/4.+Bearings.zip), converted by training/record/datasets/ims.py --seed 0 | public, MPU6050-like conversion | no |
| 7. NASA IMS run to failure, PCA default | run to failure | hours from the first alarm after learning to the failure (MPU6050-like conversion) | 4.67 | 551 snapshots, 91.83 h watched after 72 h of learning |  | `python3 -m training.validation.check_ims --rows training/validation/data/nasa-ims/test2_bearing1.npz --learn-hours 72 --smooth 3` | 0 | NASA IMS bearing data set, test 2, bearing 1 (phm-datasets.s3.amazonaws.com/NASA/4.+Bearings.zip), converted by training/record/datasets/ims.py --seed 0 | public, MPU6050-like conversion | no |
| 7. NASA IMS run to failure, PCA default | run to failure | hours from the start of the last alarm stretch to the failure (MPU6050-like conversion) | 4.67 | 551 snapshots, 91.83 h watched after 72 h of learning |  | `python3 -m training.validation.check_ims --rows training/validation/data/nasa-ims/test2_bearing1.npz --learn-hours 72 --smooth 3` | 0 | NASA IMS bearing data set, test 2, bearing 1 (phm-datasets.s3.amazonaws.com/NASA/4.+Bearings.zip), converted by training/record/datasets/ims.py --seed 0 | public, MPU6050-like conversion | no |
| 7. NASA IMS run to failure, PCA default | run to failure | hours watched after learning before the first alarm (MPU6050-like conversion) | 87.17 | 551 snapshots, 91.83 h watched after 72 h of learning |  | `python3 -m training.validation.check_ims --rows training/validation/data/nasa-ims/test2_bearing1.npz --learn-hours 72 --smooth 3` | 0 | NASA IMS bearing data set, test 2, bearing 1 (phm-datasets.s3.amazonaws.com/NASA/4.+Bearings.zip), converted by training/record/datasets/ims.py --seed 0 | public, MPU6050-like conversion | no |

## Not run

- Nothing: every check wrote a result.
