jaken31/effente/docs/research/conveyor-rig-checklist.md

# Conveyor rig checklist

Tick items as you get parts and finish steps. On GitHub, the boxes become clickable when this file is pasted into an issue or pull request description.

| Marker | Route |
|---|---|
| 🟫 | Wood route |
| 🟦 | 3D-printed route |
| ⬜ | Both routes |

Pick **one** conveyor option: A (kit), B (wood) or C (3D-printed).

## Device (already on the repo's parts list)

- [ ] ⬜ Arduino UNO Q (4 GB)
- [ ] ⬜ MPU-6500 accelerometer (MPU-9250/6500 breakout)
- [ ] ⬜ 2.42" OLED screen (SSD1309, I2C)
- [ ] ⬜ Push button
- [ ] ⬜ USB power bank, 5 V / 3 A or more, + short USB-C cable
- [ ] ⬜ Sensor cable (30–50 cm), jumper wires, breadboard
- [ ] ⬜ Sensor head: magnet, steel discs, instant glue, M3 screws, cable ties, printed head

## Conveyor: option A (kit)

- [ ] ⬜ Mini conveyor belt kit with a DC motor (check the motor mount screws and rollers are reachable)

## Conveyor: option B (wood)

- [ ] 🟫 Wood base board, about 45 × 15 cm
- [ ] 🟫 2 wood side rails, about 45 × 6 cm
- [ ] 🟫 2 × PVC pipe (about 32 mm wide, 10 cm long) + 4 end caps
- [ ] 🟫 Metal L-bracket + 2 screws (motor mount; these screws become the loose-mount fault)
- [ ] 🟫 About 10 wood screws for the frame

## Conveyor: option C (printed kit, what the team is building)

Files and print settings: [device/cad/](../../device/cad/README.md). Sized for the yellow TT gear motor: no bearings, rods or coupler.

- [ ] 🟦 TT motor shaft and gearbox measured, CAD numbers checked
- [ ] 🟦 Drive roller printed first and test-fitted on the TT shaft
- [ ] 🟦 Printed frame, idle roller and motor bracket
- [ ] 🟦 Belt: TPU print, or duct tape folded sticky-side in, 40 mm wide
- [ ] 🟦 TT gear motor (+ 1 spare)
- [ ] 🟦 2 × M3 bolts (8–10 mm) + nuts for the motor bracket (the loose-mount fault)
- [ ] 🟦 2 zip ties (motor into bracket)
- [ ] 🟦 Grease or petroleum jelly on the roller pins
- [ ] 🟦 Frame on a rubber mat or taped to the table

## Shared conveyor parts (option B)

- [ ] ⬜ 4 × 608 skateboard bearings
- [ ] ⬜ 2 × 8 mm steel rods, about 20 cm (or M8 bolts)
- [ ] ⬜ Rubber strip or resistance band, about 9 cm wide (the belt)
- [ ] ⬜ DC gear motor, 6–12 V, about 100–300 rpm (+ 1 spare)
- [ ] ⬜ Shaft coupler (motor shaft size → 8 mm). Measure the motor shaft first
- [ ] ⬜ 2–4 shaft collars (8 mm) or tape

## Conveyor power (fixed speed)

- [ ] ⬜ Regulated DC supply matching the motor (e.g. 9 or 12 V, 1 A+), or an adjustable buck converter + wall adapter
- [ ] 🟦 TT motor: 5 V USB charger with a cut cable, or a TB6612FNG driver + Arduino Nano at one fixed PWM value
- [ ] ⬜ On/off switch + wires
- [ ] ⬜ Conveyor motor kept separate from the UNO Q

## Fault kit

- [ ] ⬜ Modelling clay or coins + tape (imbalance: buildup on the drive roller)
- [ ] ⬜ Screwdriver (loose mount: loosen the 2 mount screws)
- [ ] ⬜ Several sizes of weight (sensitivity sweep)
- [ ] ⬜ Washers (misalignment: held out for the "unknown" test)
- [ ] ⬜ Duct tape (belt damage: stretch only, not in the current 3 classes)
- [ ] ⬜ Rubber mat for the table

## Sensor placement

- [ ] ⬜ Magnetic steel disc (about 20 mm) glued at the probe point: the pocket on the printed frame's wall, or the side rail next to the drive-roller bearing
- [ ] ⬜ Probe point marked; same spot for every recording
- [ ] ⬜ Sensor NOT on the motor mount (it gets loosened in the demo)

## Tools

- [ ] 🟫 Drill + 22 mm bit (bearings) + 8 mm bit (end caps)
- [ ] 🟫 Saw
- [ ] 🟦 3D printer + PETG filament (PLA softens at about 50–70 °C)
- [ ] ⬜ Screwdriver
- [ ] ⬜ Hot glue or epoxy
- [ ] ⬜ Calipers (measure every part)
- [ ] ⬜ Phone slow-motion video or tachometer (roller speed)

## Before recording

- [ ] ⬜ Motor shaft measured; coupler fits (option B) or drive roller fits the shaft (option C)
- [ ] ⬜ Power supply matches motor voltage and current
- [ ] 🟦 Motor bracket and sensor head printed solid; rollers printed upright, round, with no wobble
- [ ] ⬜ Rollers spin with no visible wobble
- [ ] ⬜ Belt runs straight and doesn't slip
- [ ] ⬜ Healthy run is smooth
- [ ] ⬜ Roller speed measured and shared with the model team
- [ ] ⬜ All training data recorded on this same finished rig
- [ ] ⬜ Prices checked on live listings (none have been checked yet)
