jaken31/effente/docs/design/desktop-dashboard-mockup-red-apple.html

effenteconsole

Machine

effente-sim-01

Modewatching

Modelconveyor, calibrated

Receiver0.0.0.0:8000

Records1 / s

Thermal4 frames / s

Stored

# conveyor-07/Live

current reading Simulated data

## Signals

now, and the last 5 minutes · click a row for detail

Signal | Now | Context | Last 5 min

## Spectrum

20 vibration bands, 5 to 500 Hz · dashed line is the calibrated baseline

## Thermal

## Timeline

last 5 minutes, as the dashboard labels them

## Events

alarms, answers, mode changes, agent runs

Time | Type | Event

## Controls

LowBalancedHigh

Fewer false alarmsFlags drift earlier

Run Report Agent Bookmark Export Session

### Simulator

Vibration

NormalWeightLooseUnusual

Thermal

NormalHot spotArea cold

Press Device ButtonPauseReplay File…

## Trends

Export CSV

## Alarms

each alarm asks one question: real problem or false alarm?

Started | Ended | Diagnosis | Group | Periods | Model | Answer

## Records

Seq | Time (UTC) | Diagnosis | This period | Confidence | Score | Periods | Top reading

## Spectrum

20 bands · log10 level · hover a band

Hover a band to see its range and level.

## Waterfall

last 120 periods · newest on top

## Bands

strongest change from the calibrated baselineUse Current as Baseline

Band | Range Hz | Level | Baseline | Difference | × baseline

Hottest

Above room

Average

Hot pixels15 °C or more above room

Fastest changeany pixel, per second

Scene match

## Thermal camera

optional sensor · MLX90640 · 32 × 24 · 4 fps

Auto range20 to 60 °C

SmoothPixels

Grid

Hover the image to read a pixel. Sim case

NormalHot spotArea cold

## Heat trend

last 2 min, above roomhottestbearing endfan cover

## Grid

8 × 6 cells · average and hottest point above room

## Readings that moved

signed spreads from this machine's normal · 6 or more counts as evidence

## Fault type evidence

## Fault types

21 general types, the same on every machine · none validated on the rig yet, so all show as "possible"

Group | Type | What it means | Status | Evidence now

## Agent fleet

runs on this laptop

maintenance_report

setup (later)

review (later)

Stand-inLive Claude

Run Report Agent

## Tool calls

Time | Tool | Input | Output

Select a tool call to see its full input and output.

## Report

## Devices

Device | Status | Mode | Last seen | Machine | Model version | Records

## Model

from the library, calibrated to this machine

## Event log

Pause

Time | Event | Detail
