jaken31/effente/platform/desktop/reference/agent.png

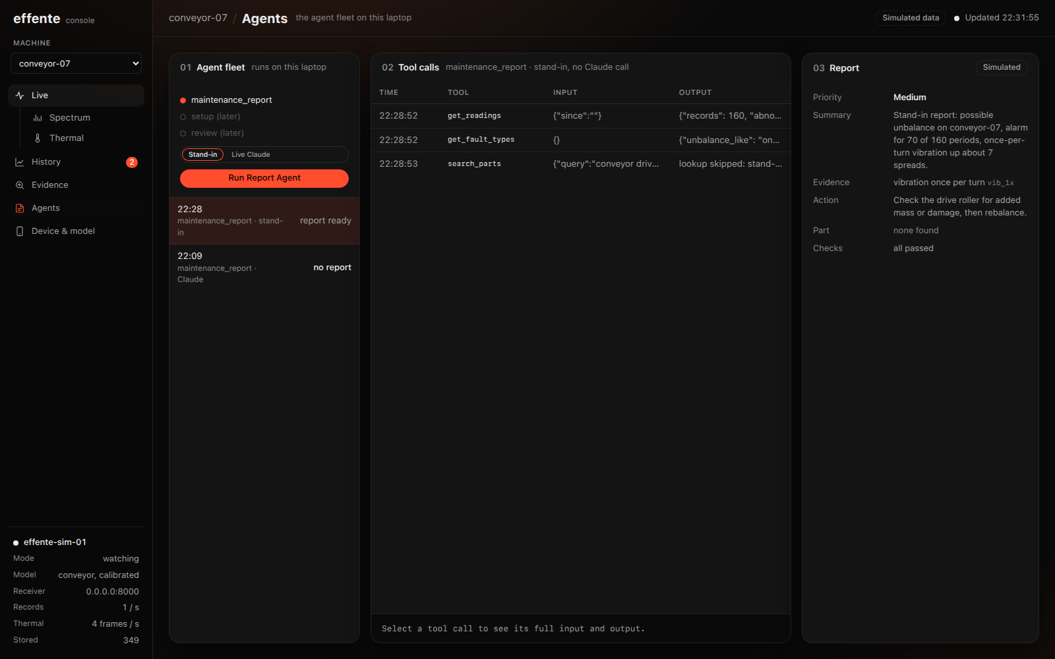
platform/desktop/reference/agent.png
