jaken31/effente/platform/desktop/reference/device.png

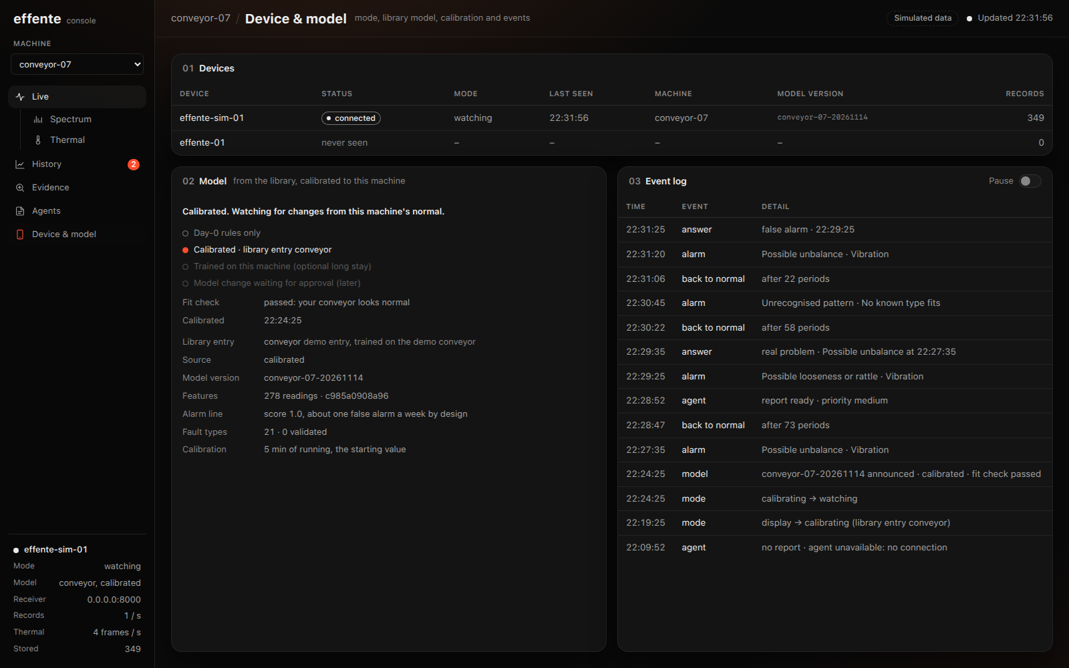
platform/desktop/reference/device.png
