jaken31/effente/platform/desktop/reference/evidence.png

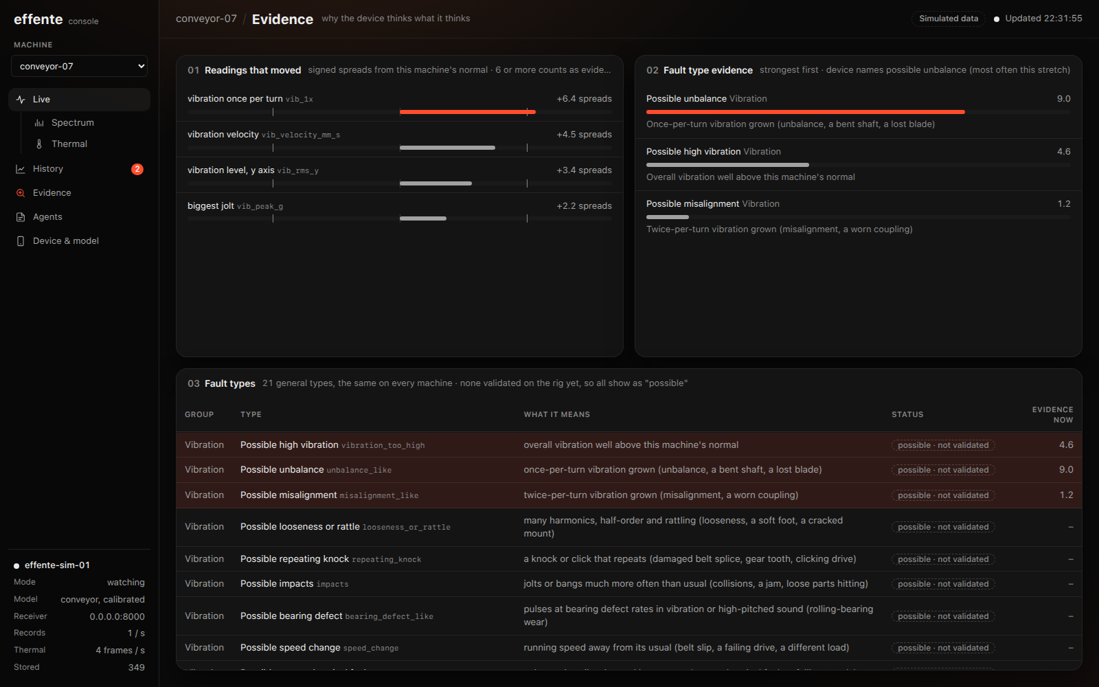
platform/desktop/reference/evidence.png
