jaken31/effente/platform/desktop/reference/live.png

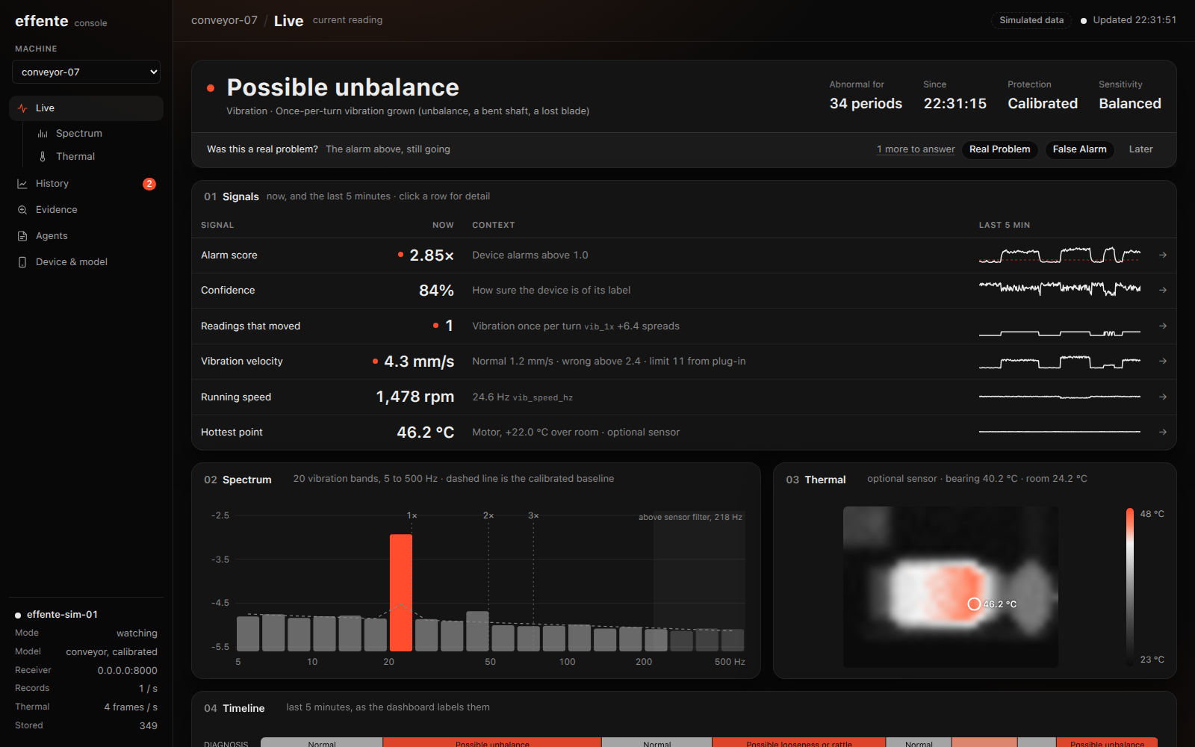
platform/desktop/reference/live.png
