jaken31/effente/platform/desktop/reference/spectrum.png

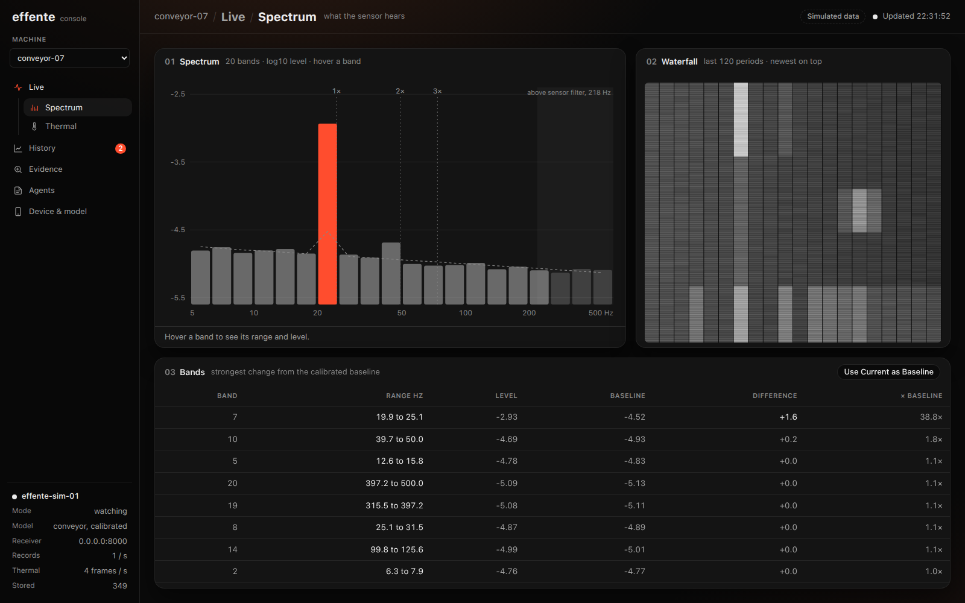
platform/desktop/reference/spectrum.png
