jaken31/effente/platform/desktop/reference/thermal.png

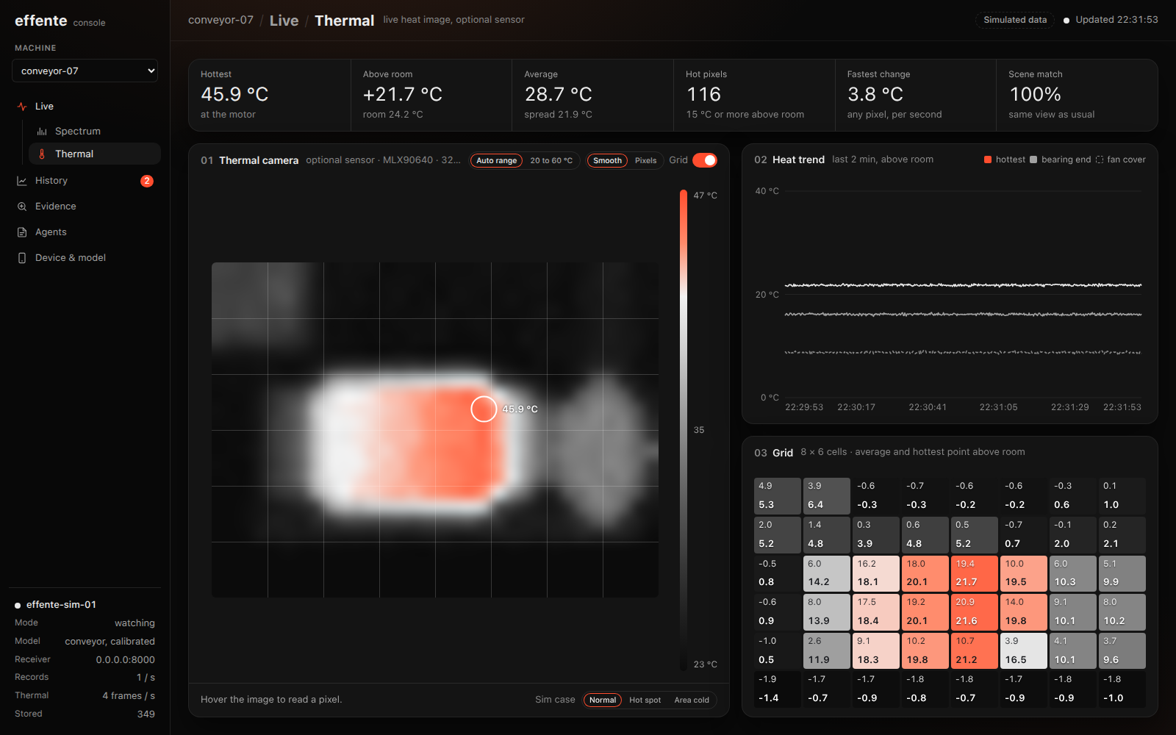
platform/desktop/reference/thermal.png
