jaken31/effente/platform/desktop/screenshots/e2e/00-normal.png

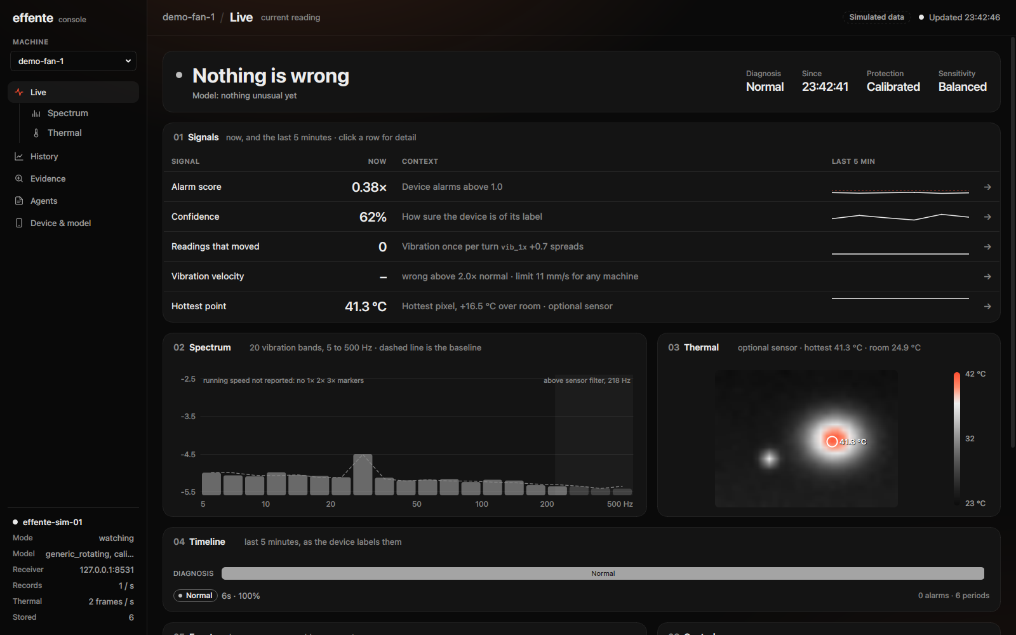
platform/desktop/screenshots/e2e/00-normal.png
