jaken31/effente/platform/desktop/screenshots/e2e/01-unbalance.png

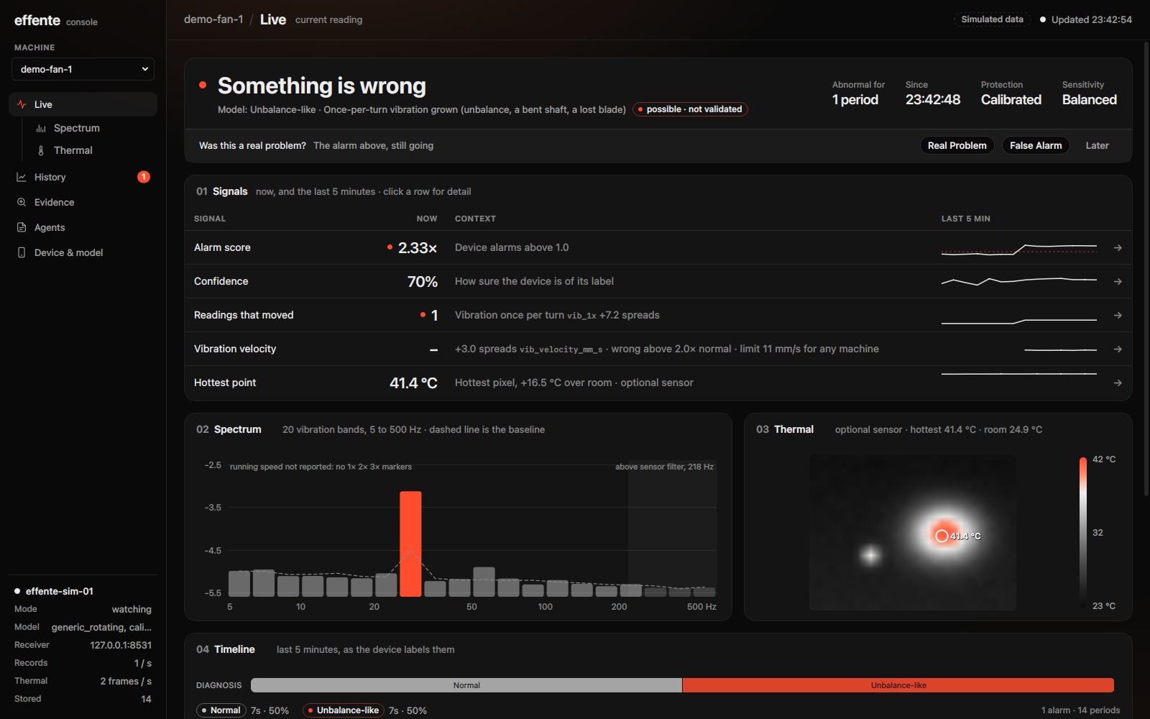
platform/desktop/screenshots/e2e/01-unbalance.png
