jaken31/effente/platform/desktop/screenshots/e2e/02-looseness.png

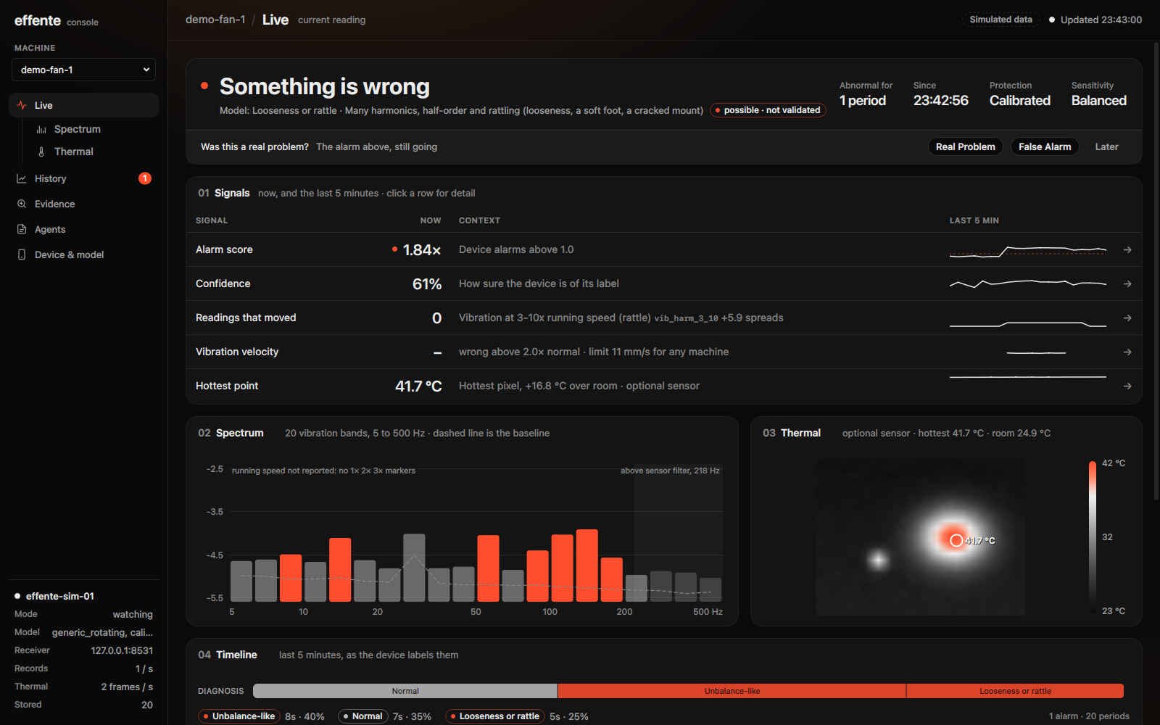
platform/desktop/screenshots/e2e/02-looseness.png
