jaken31/effente/platform/desktop/screenshots/e2e/03-unrecognised.png

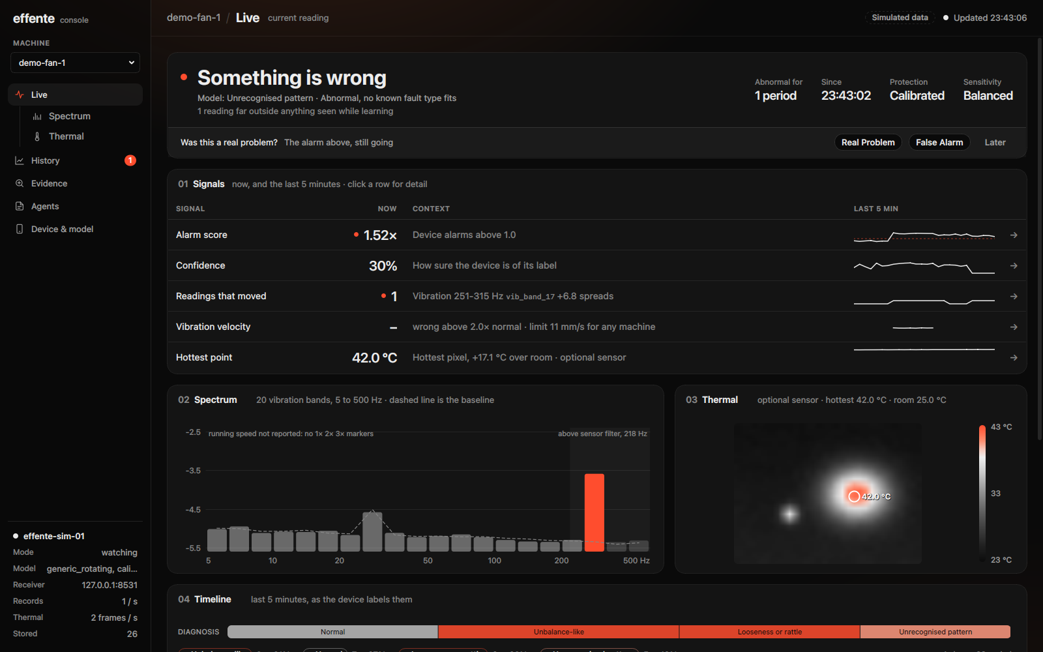
platform/desktop/screenshots/e2e/03-unrecognised.png
