jaken31/effente/platform/desktop/screenshots/e2e/04-too-hot-while-normal.png

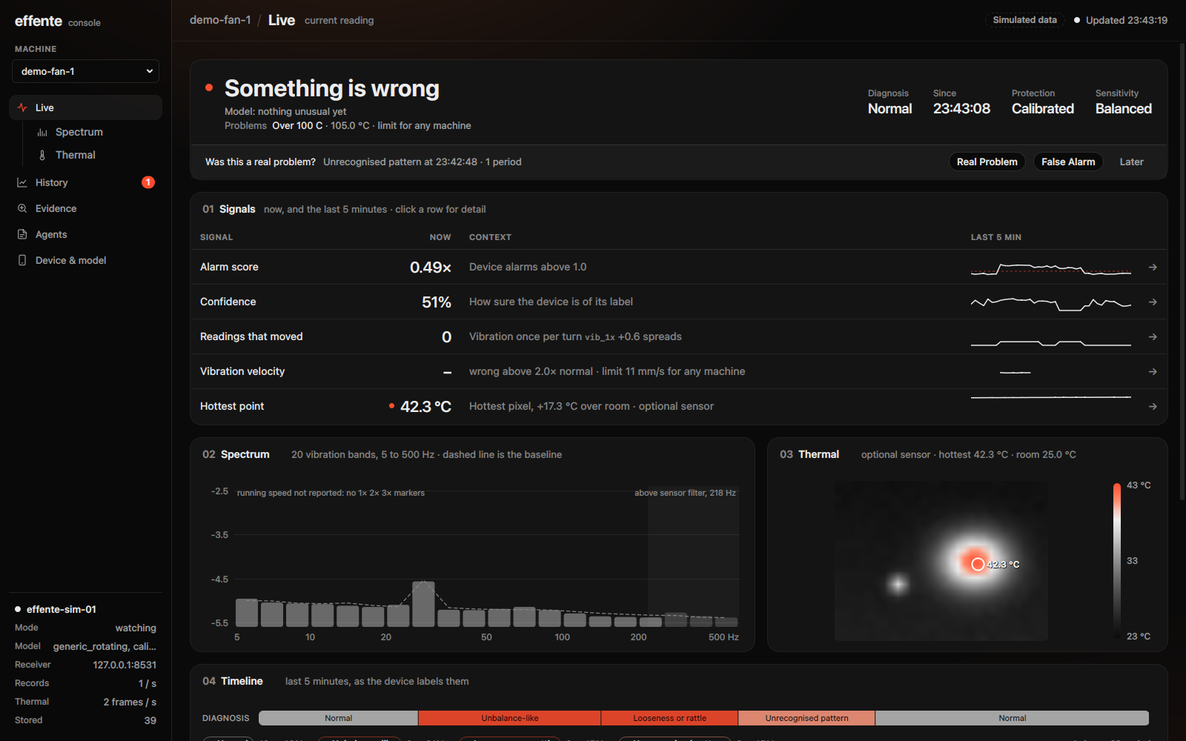
platform/desktop/screenshots/e2e/04-too-hot-while-normal.png
