jaken31/effente/platform/desktop/screenshots/e2e/05-stopped.png

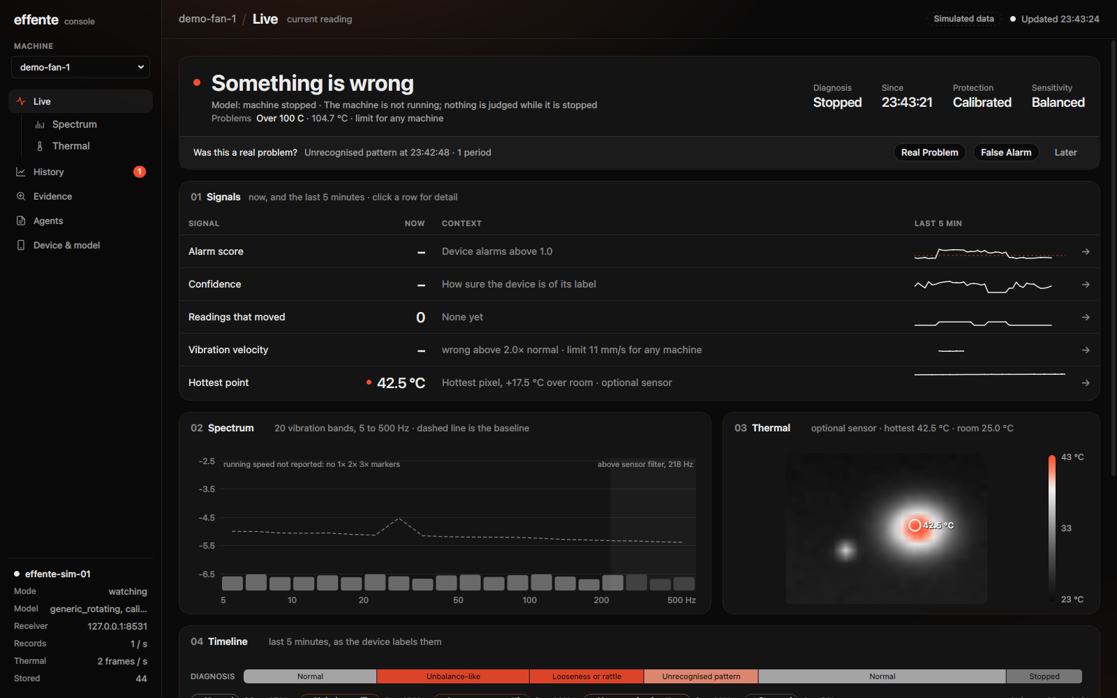
platform/desktop/screenshots/e2e/05-stopped.png
