jaken31/effente/platform/desktop/screenshots/e2e/08-back-to-watching.png

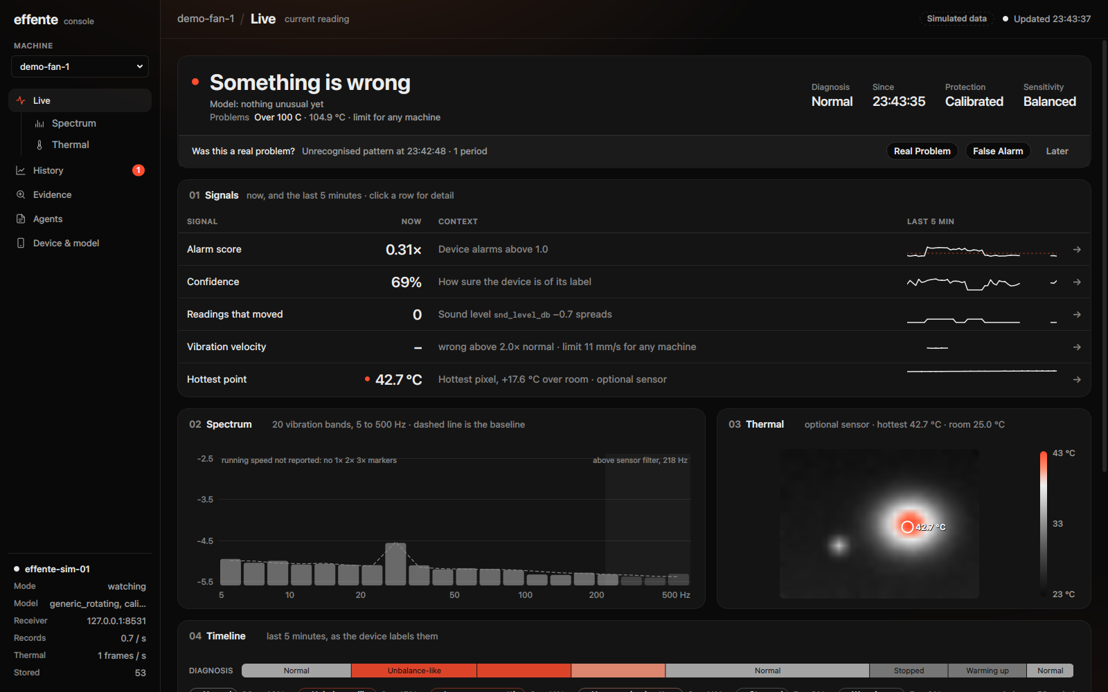
platform/desktop/screenshots/e2e/08-back-to-watching.png
