jaken31/effente/platform/desktop/screenshots/e2e/10-sensitivity-low.png

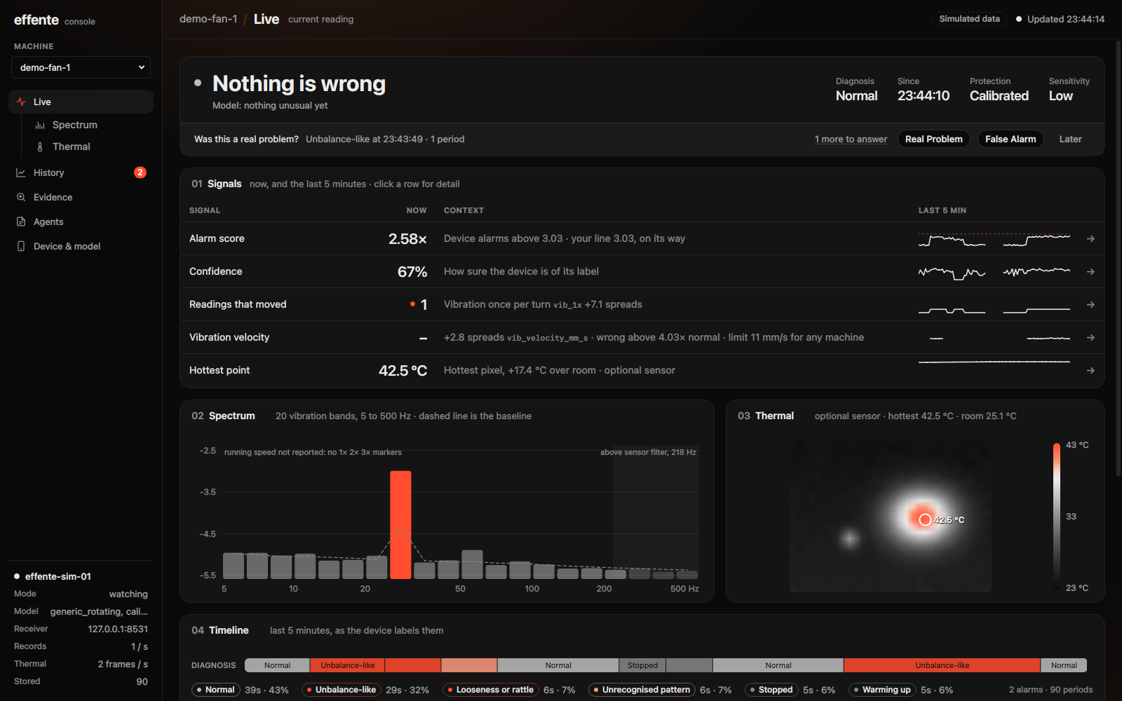
platform/desktop/screenshots/e2e/10-sensitivity-low.png
