jaken31/effente/platform/desktop/screenshots/e2e/page-agent.png

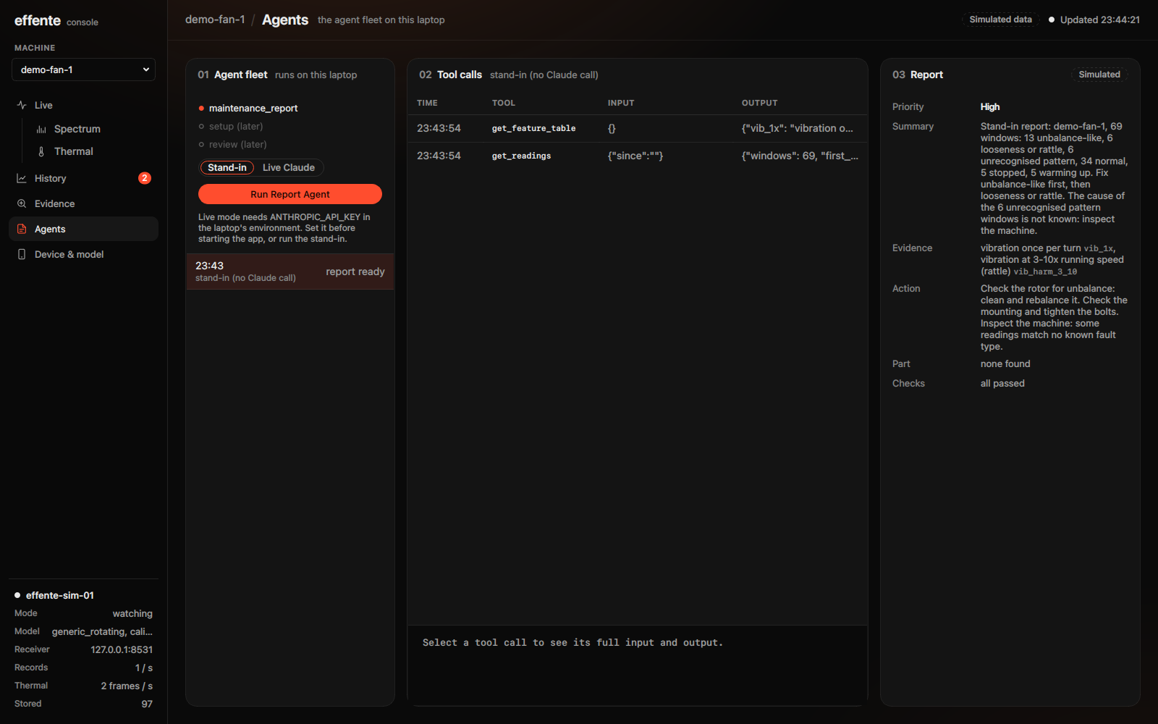
platform/desktop/screenshots/e2e/page-agent.png
