jaken31/effente/platform/desktop/screenshots/e2e/page-device.png

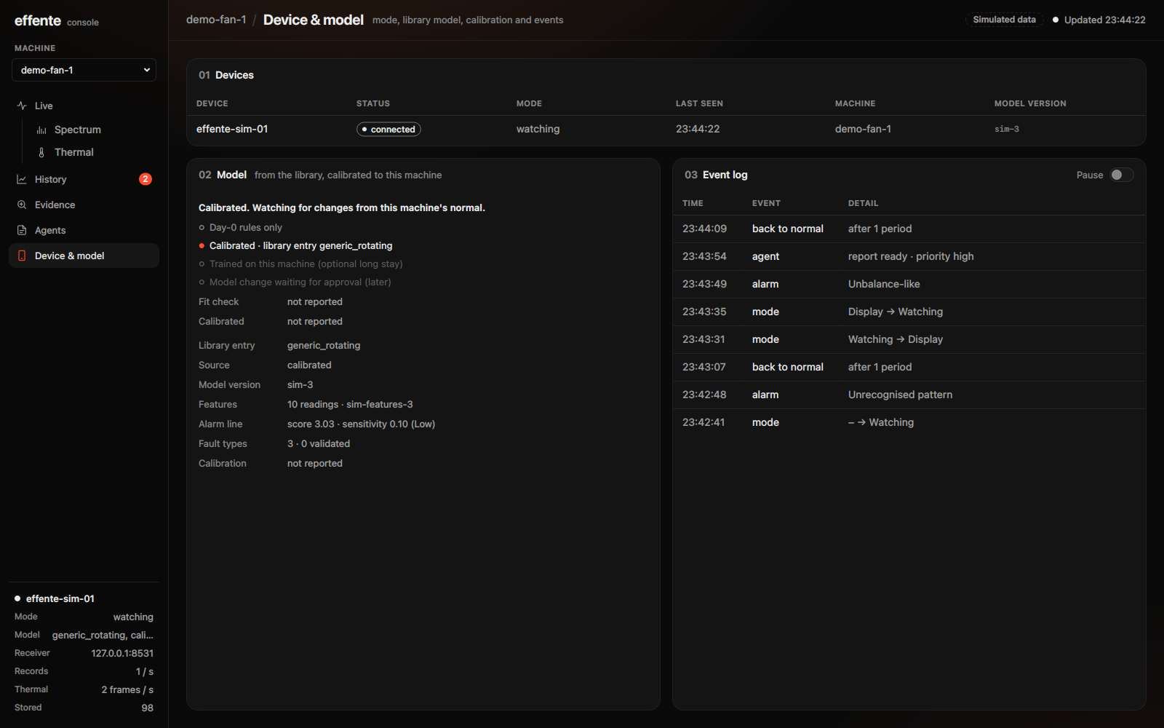
platform/desktop/screenshots/e2e/page-device.png
