jaken31/effente/platform/desktop/screenshots/e2e/page-evidence.png

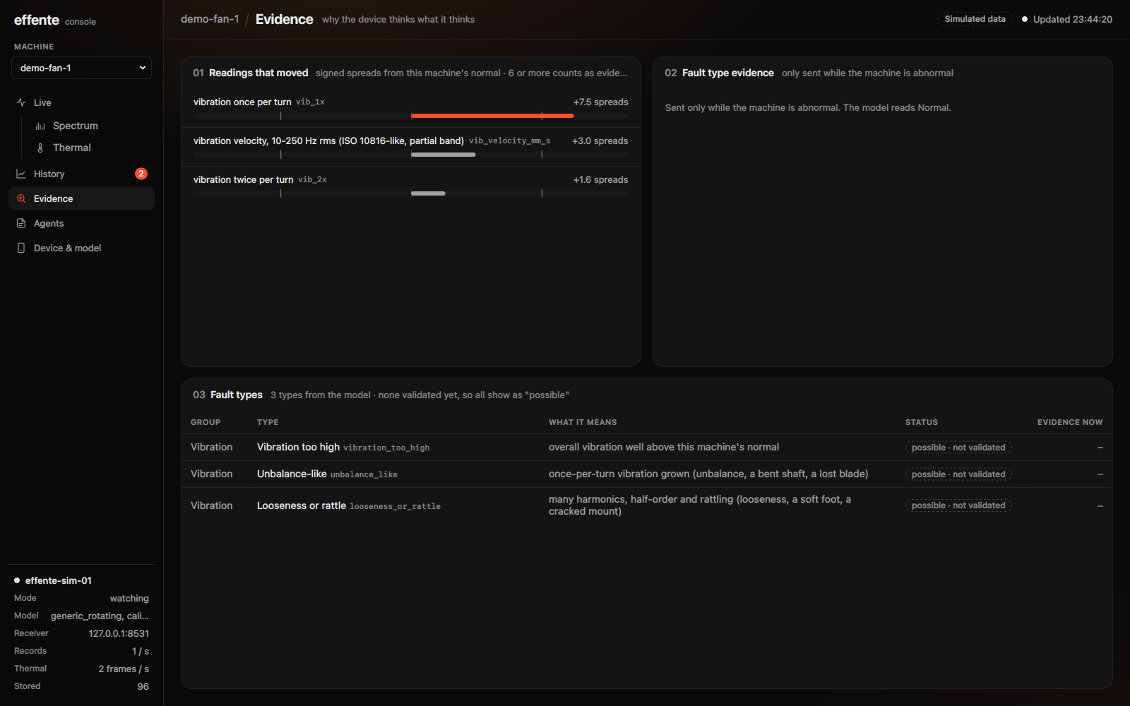
platform/desktop/screenshots/e2e/page-evidence.png
