jaken31/effente/platform/desktop/screenshots/e2e/page-spectrum.png

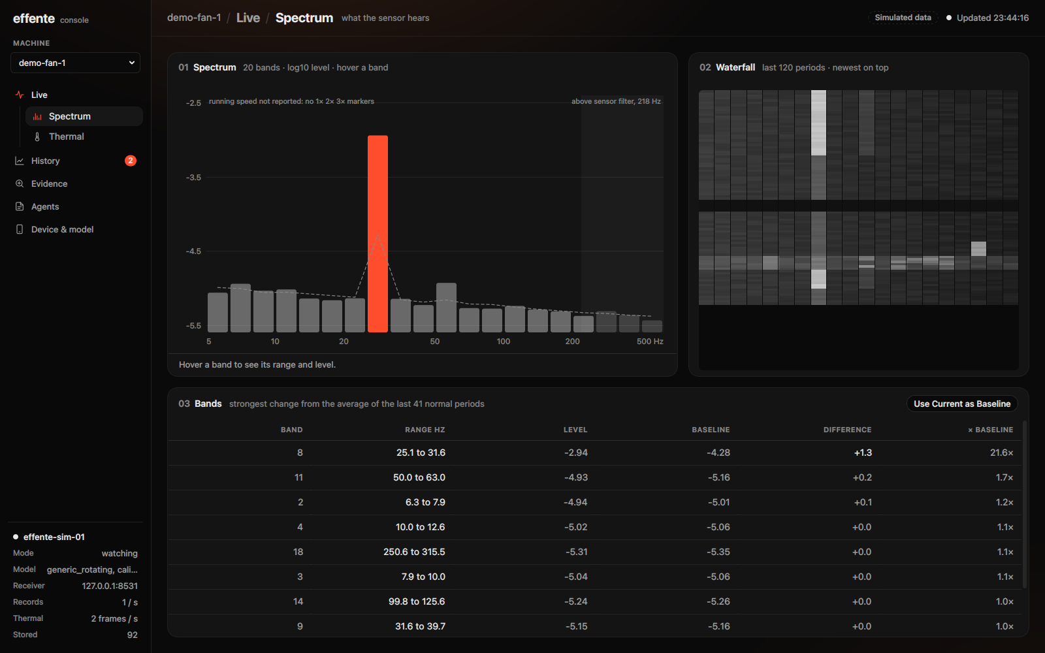
platform/desktop/screenshots/e2e/page-spectrum.png
