jaken31/effente/platform/desktop/screenshots/e2e/page-thermal.png

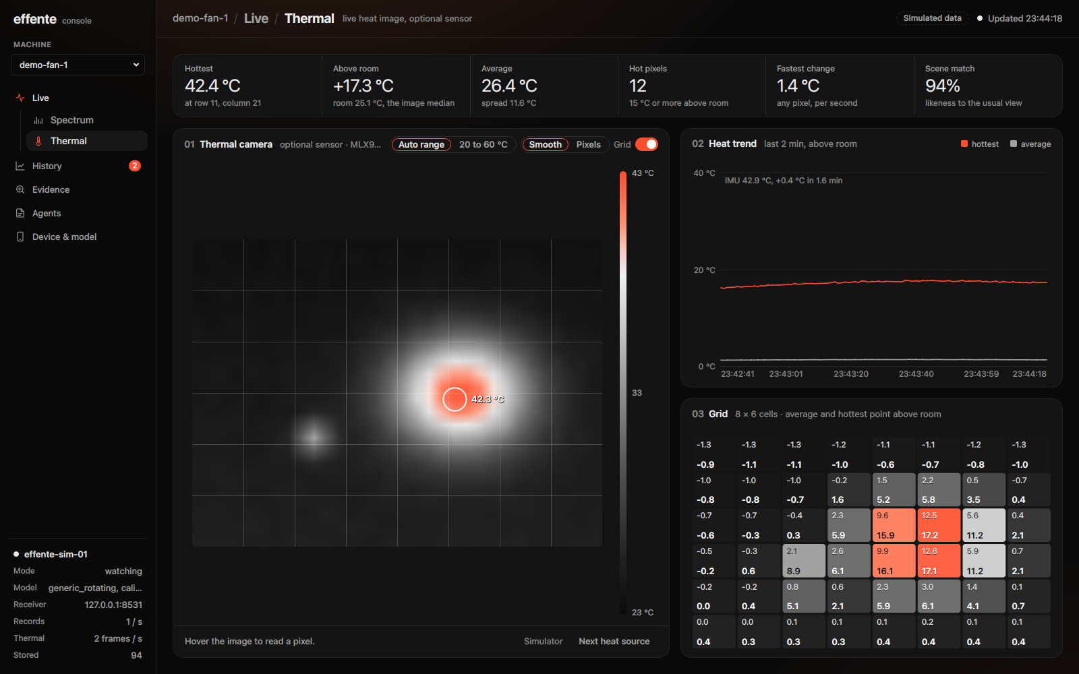
platform/desktop/screenshots/e2e/page-thermal.png
