jaken31/effente/platform/desktop/screenshots/log/log-agree.png

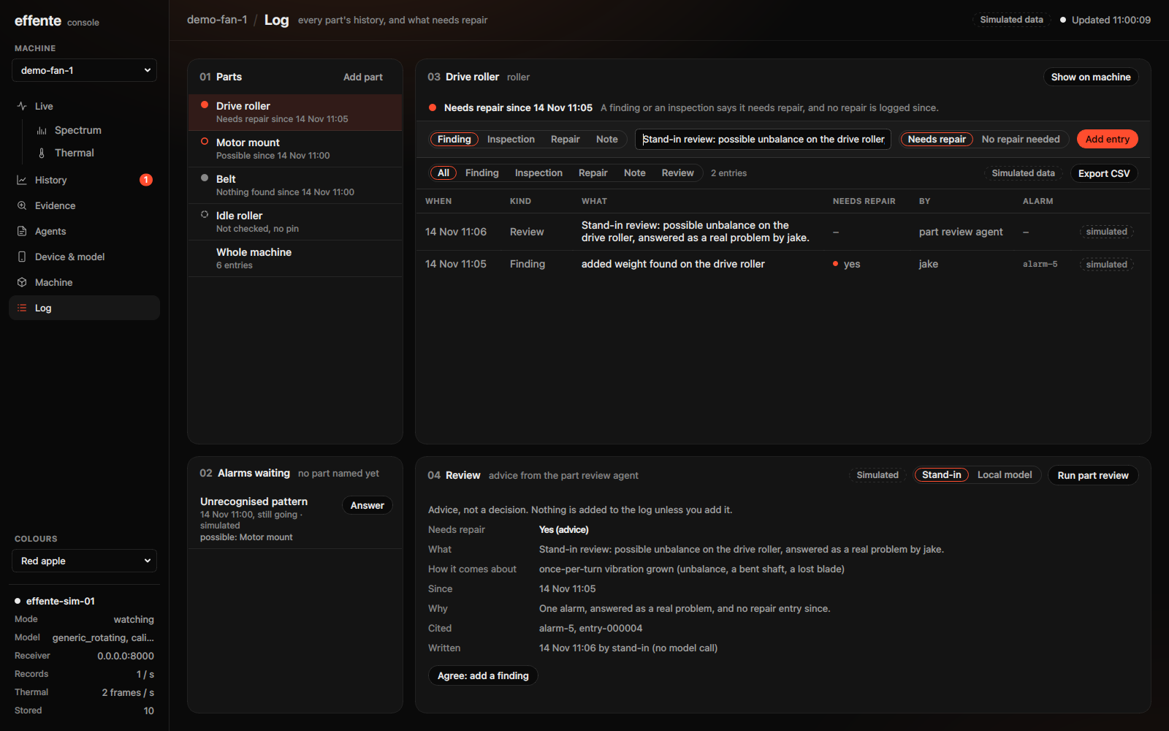
platform/desktop/screenshots/log/log-agree.png
