jaken31/effente/platform/desktop/screenshots/log/log-answering.png

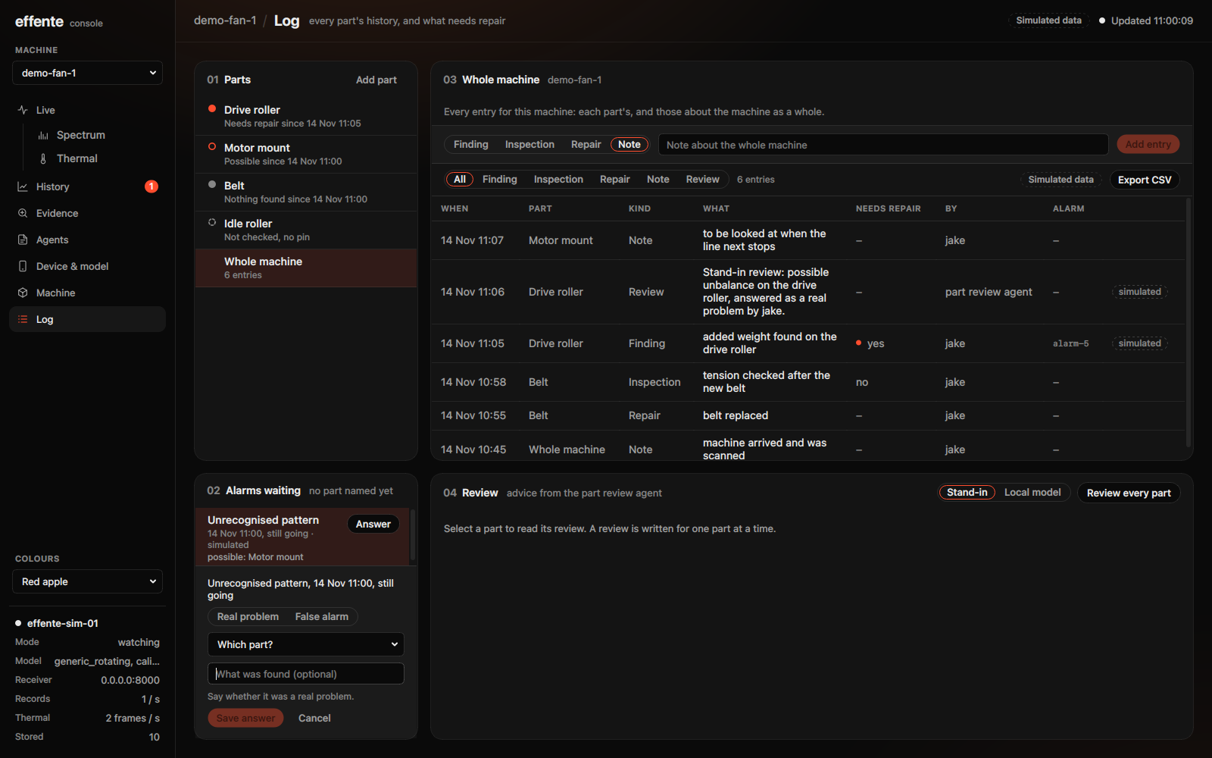
platform/desktop/screenshots/log/log-answering.png
