jaken31/effente/platform/desktop/screenshots/log/log-no-entries.png

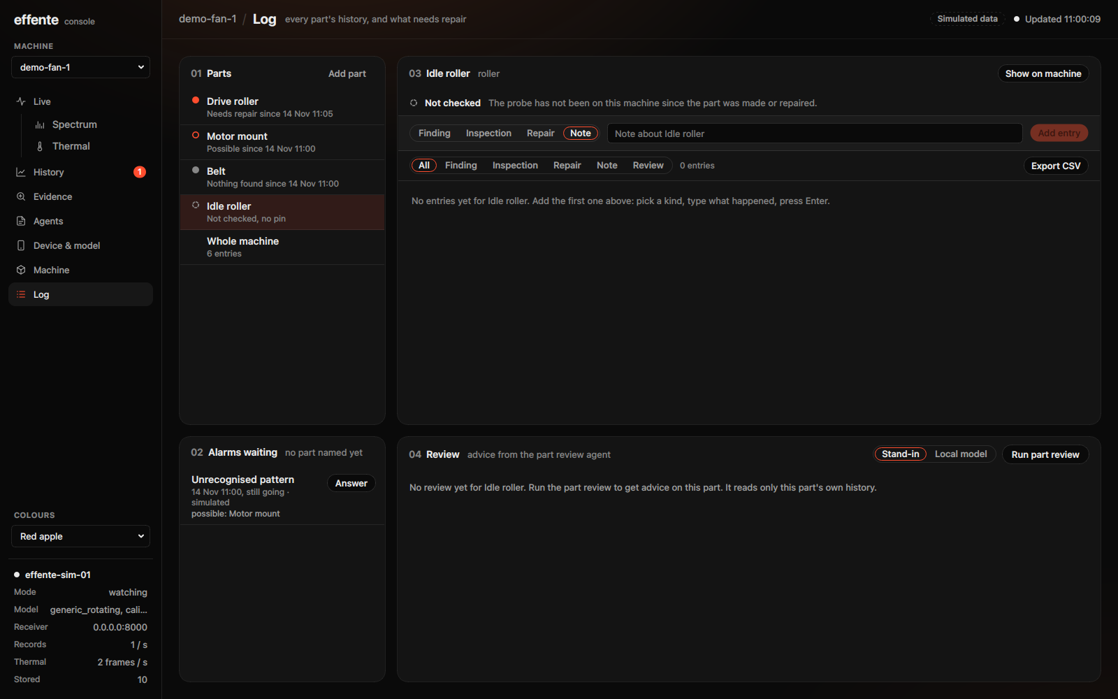
platform/desktop/screenshots/log/log-no-entries.png
