jaken31/effente/platform/desktop/screenshots/review/evidence.png

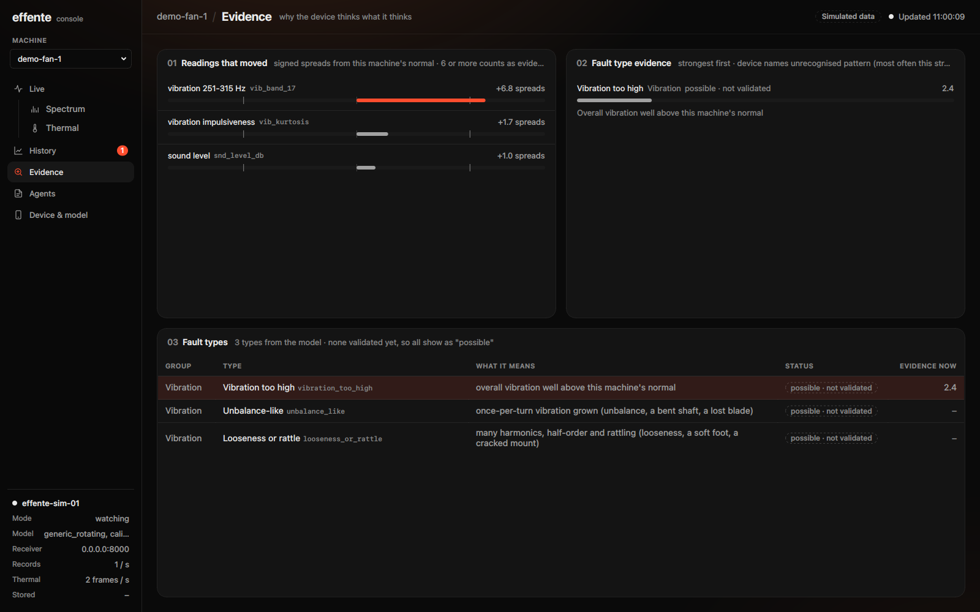
platform/desktop/screenshots/review/evidence.png
