jaken31/effente/platform/desktop/screenshots/shell/live-stale.png

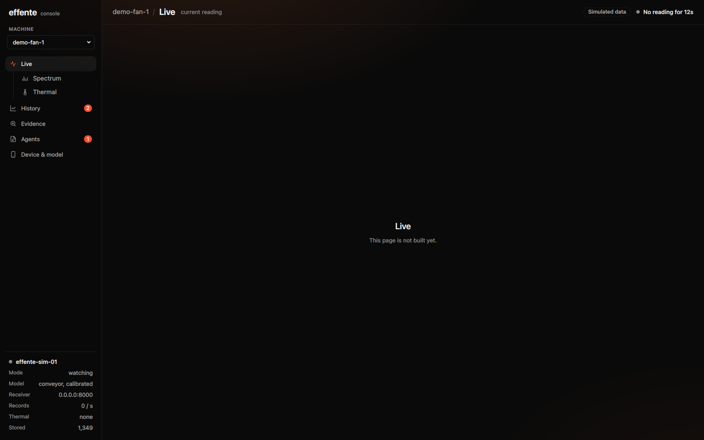
platform/desktop/screenshots/shell/live-stale.png
