jaken31/effente/platform/desktop/screenshots/signal/spectrum.png

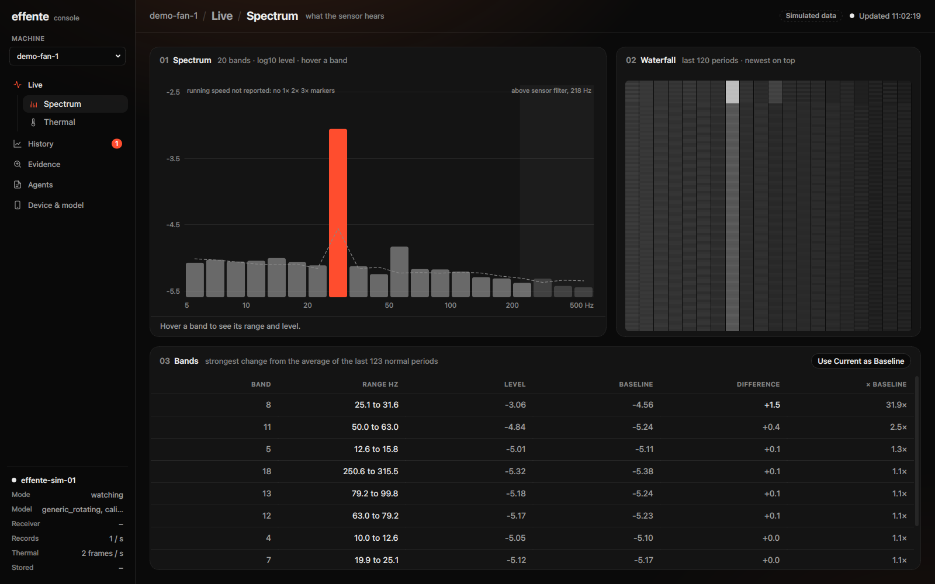
platform/desktop/screenshots/signal/spectrum.png
