jaken31/effente/platform/desktop/screenshots/signal/thermal-empty.png

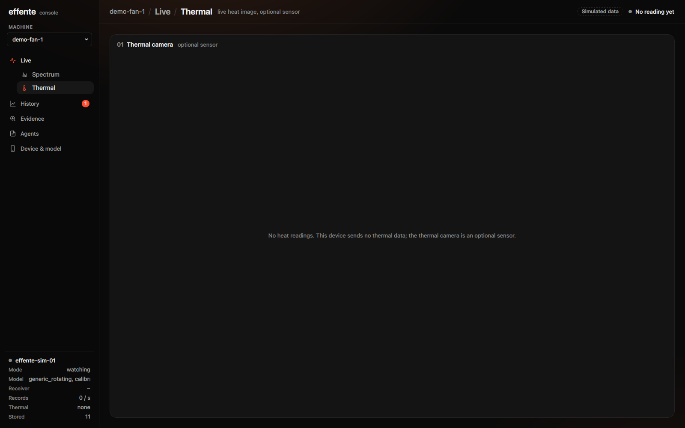
platform/desktop/screenshots/signal/thermal-empty.png
