jaken31/effente/platform/desktop/screenshots/log/log-no-parts.png

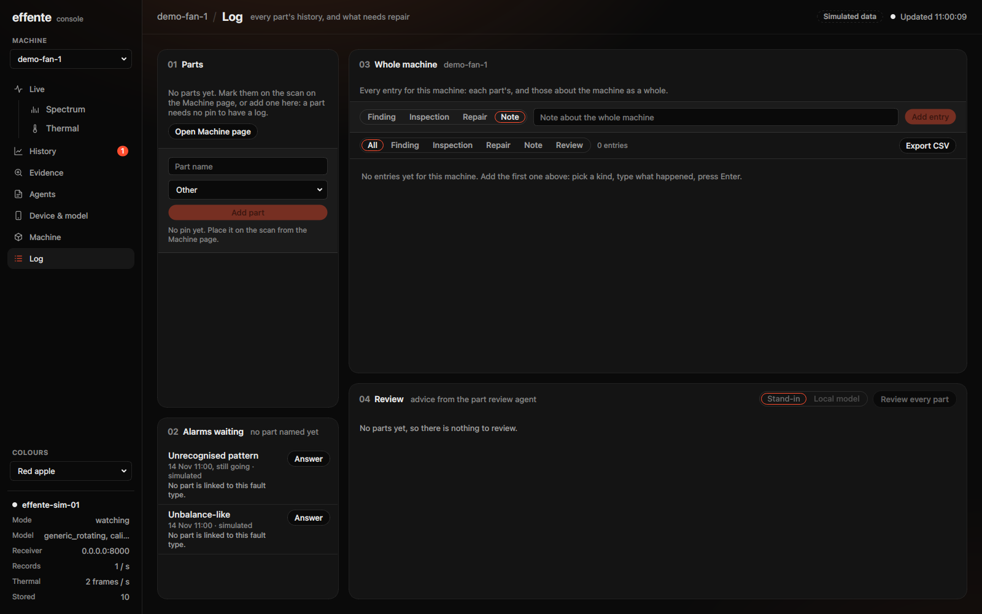
platform/desktop/screenshots/log/log-no-parts.png
