jaken31/effente/device/cad/effente-cad.stl

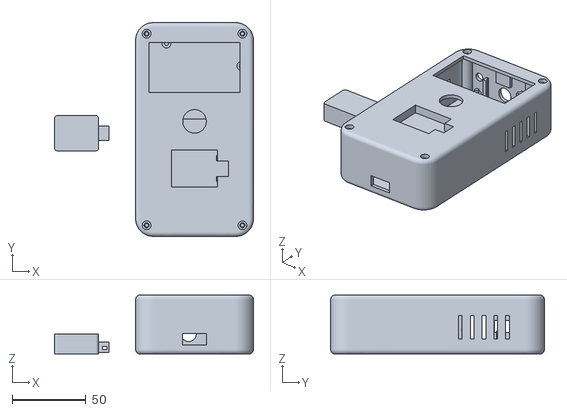
[picture p33: CAD file, 2026-11-12]
device/cad/effente-cad.stl
135.0 x 145.0 x 40.0
