jaken31/effente/device/cad/files/effente_device.step

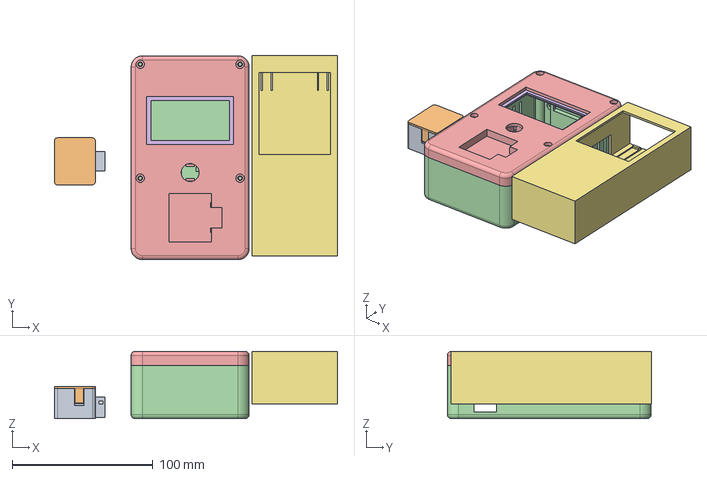
[picture p34: CAD file, 2026-11-13]
device/cad/files/effente_device.step
201.3 x 145.4 x 48.0 mm
