jaken31/effente/device/cad/print/device_bank_holder.stl

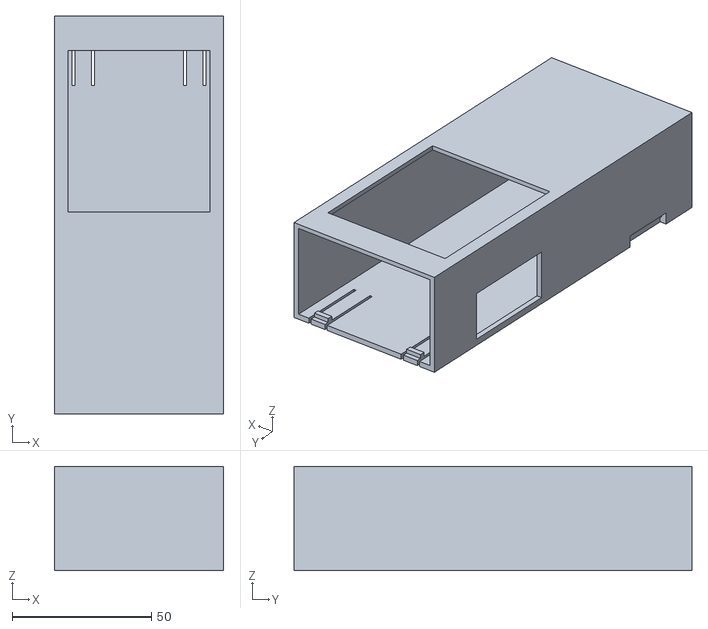
[picture p35: CAD file, 2026-11-13]
device/cad/print/device_bank_holder.stl
60.8 x 142.8 x 37.4
