jaken31/effente/device/cad/files/effente_conveyor.step

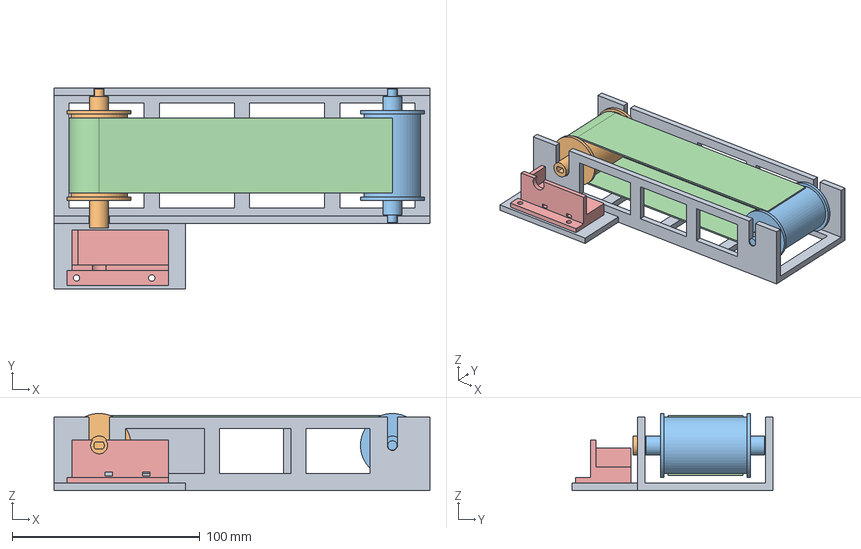
[picture p36: CAD file, 2026-11-12]
device/cad/files/effente_conveyor.step
200.0 x 107.0 x 41.0 mm
