jaken31/effente/device/cad/print/device_imu_cradle.stl

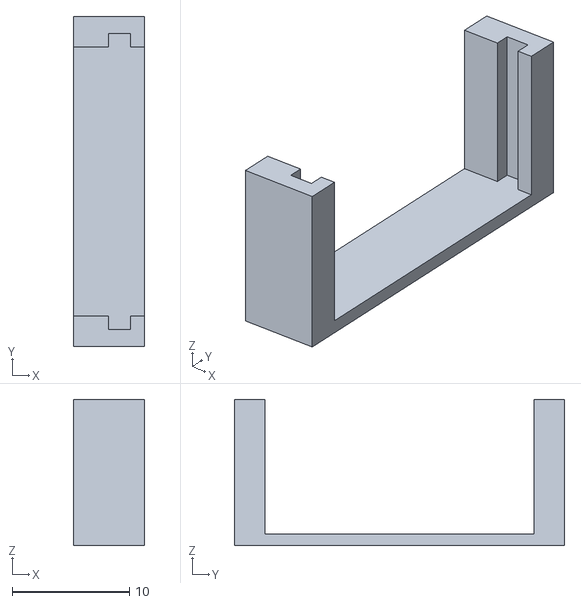
[picture p37: CAD file, 2026-11-13]
device/cad/print/device_imu_cradle.stl
6.10 x 28.2 x 12.5
