jaken31/effente/device/cad/print/device_head_lid.stl

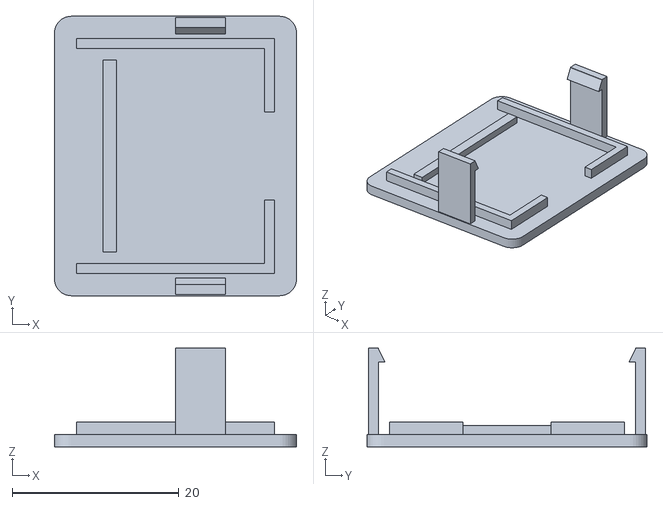
[picture p38: CAD file, 2026-11-13]
device/cad/print/device_head_lid.stl
29.0 x 33.5 x 11.9
