jaken31/effente/device/cad/print/device_front_lid.stl

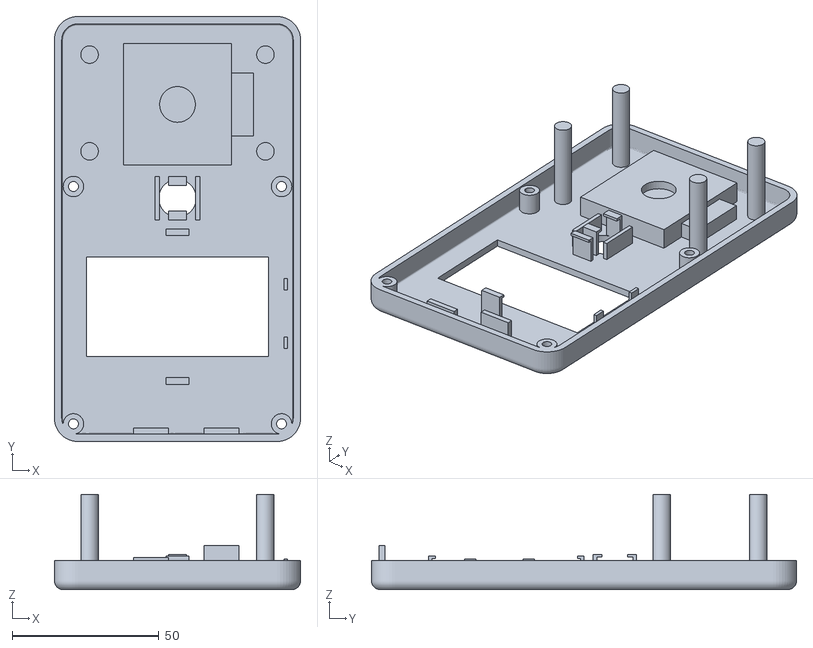
[picture p39: CAD file, 2026-11-13]
device/cad/print/device_front_lid.stl
84.0 x 145.0 x 32.5
