jaken31/effente/device/cad/print/device_sensor_head.stl

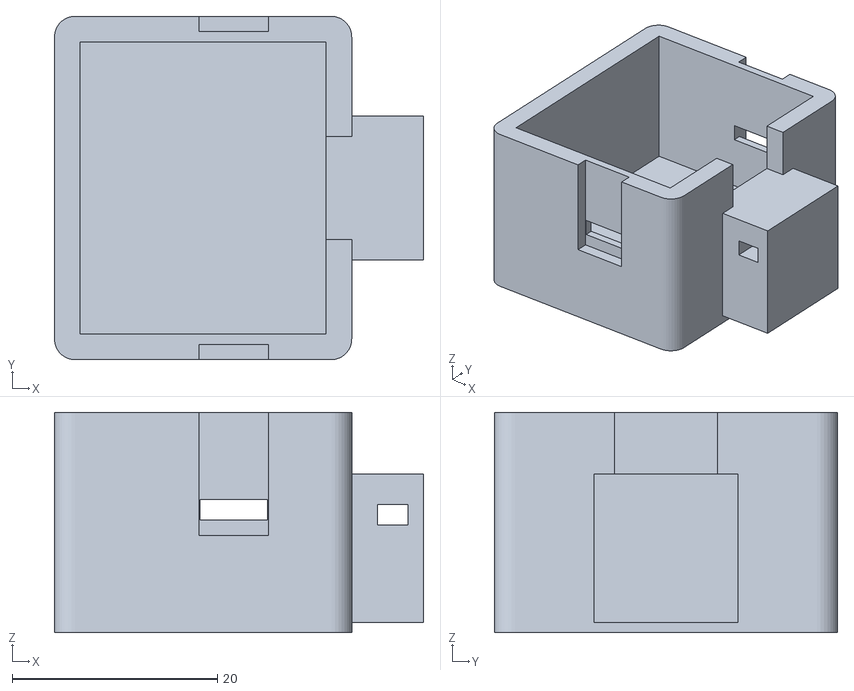
[picture p40: CAD file, 2026-11-13]
device/cad/print/device_sensor_head.stl
36.0 x 33.5 x 21.5
