jaken31/effente/device/cad/print/device_screen_tray.stl

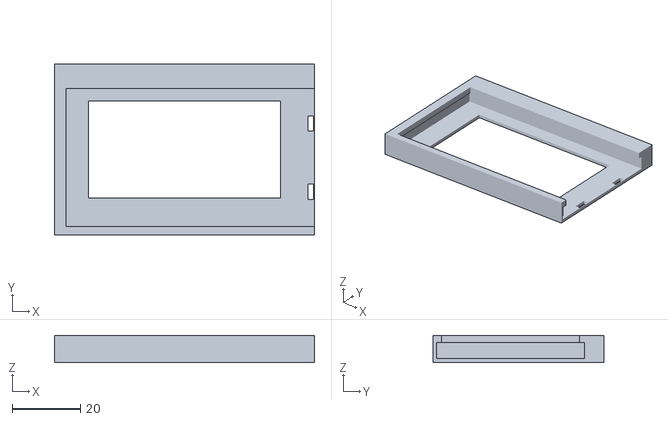
[picture p41: CAD file, 2026-11-13]
device/cad/print/device_screen_tray.stl
76.0 x 50.0 x 8.00
