jaken31/effente/device/cad/print/conveyor_idle_roller.stl

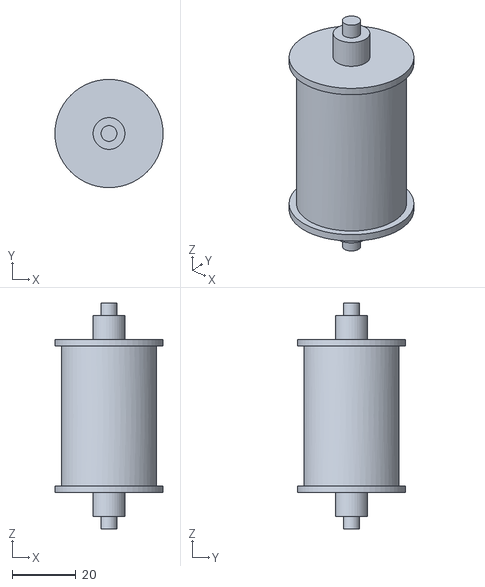
[picture p42: CAD file, 2026-11-12]
device/cad/print/conveyor_idle_roller.stl
34.0 x 34.0 x 71.0
