jaken31/effente/device/cad/print/conveyor_motor_bracket.stl

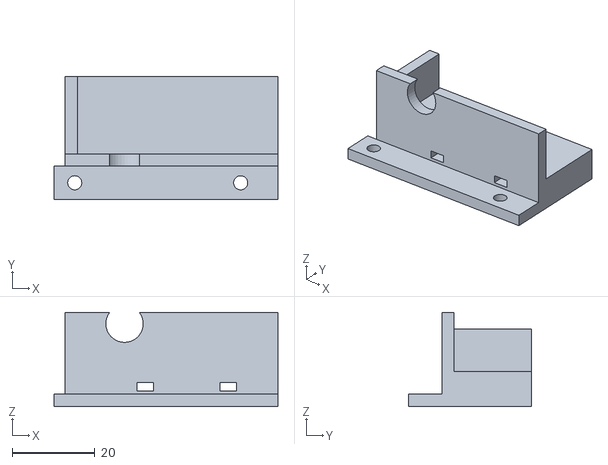
[picture p43: CAD file, 2026-11-12]
device/cad/print/conveyor_motor_bracket.stl
54.0 x 29.6 x 22.8
