jaken31/effente/device/cad/print/conveyor_frame.stl

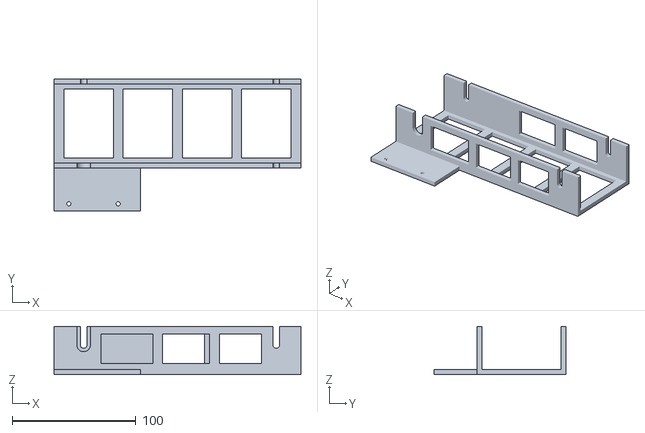
[picture p44: CAD file, 2026-11-12]
device/cad/print/conveyor_frame.stl
200.0 x 107.0 x 39.0
