jaken31/effente/device/cad/print/conveyor_belt_TPU.stl

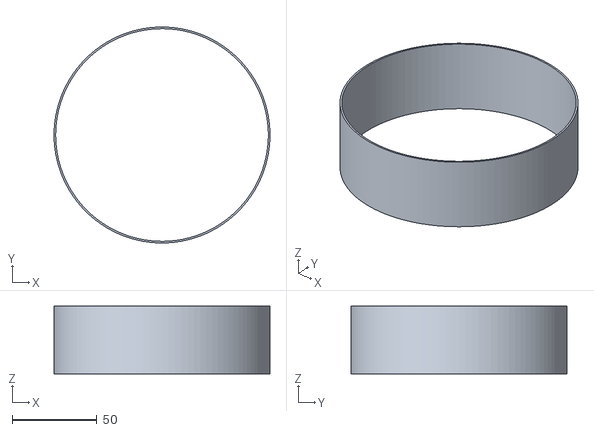
[picture p45: CAD file, 2026-11-12]
device/cad/print/conveyor_belt_TPU.stl
127.7 x 127.7 x 40.0
