jaken31/effente/device/cad/print/device_back_shell.stl

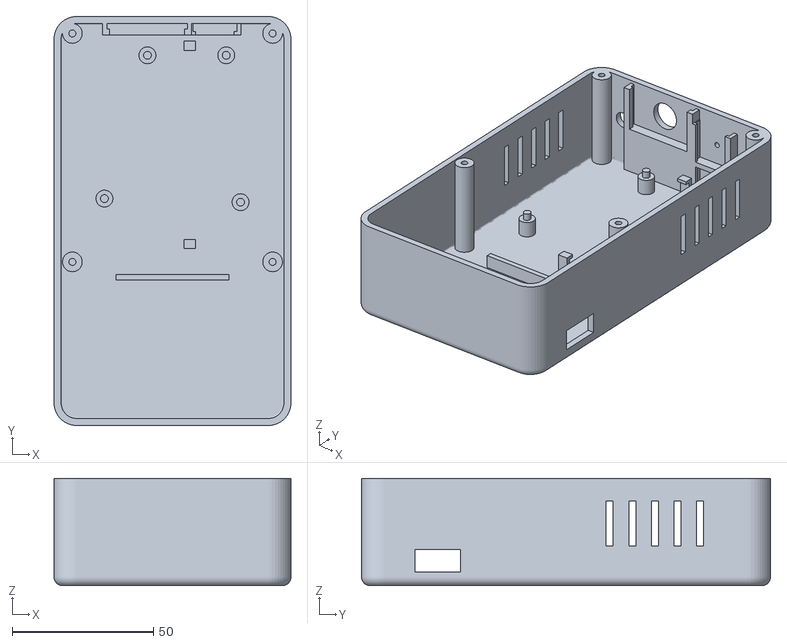
[picture p46: CAD file, 2026-11-12]
device/cad/print/device_back_shell.stl
84.0 x 145.0 x 38.0
