jaken31/effente/device/cad/print/conveyor_drive_roller.stl

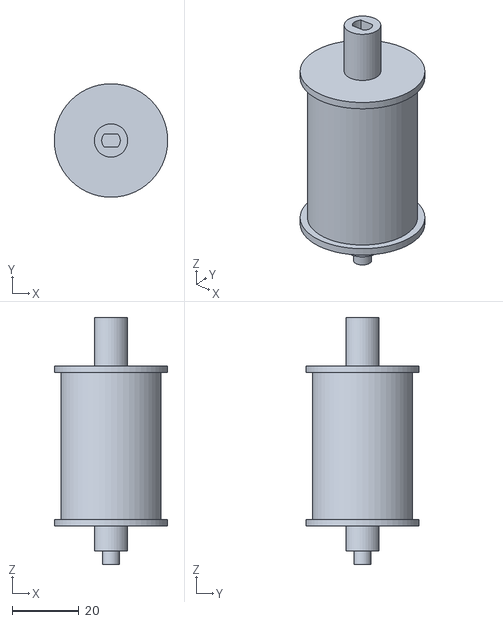
[picture p47: CAD file, 2026-11-12]
device/cad/print/conveyor_drive_roller.stl
34.0 x 34.0 x 74.0
