jaken31/effente/(list of files, cad)

Other CAD files:
device/cad/files/effente_conveyor.f3d
device/cad/files/effente_device.f3d
