jaken31/effente/platform/desktop/reference/history.png

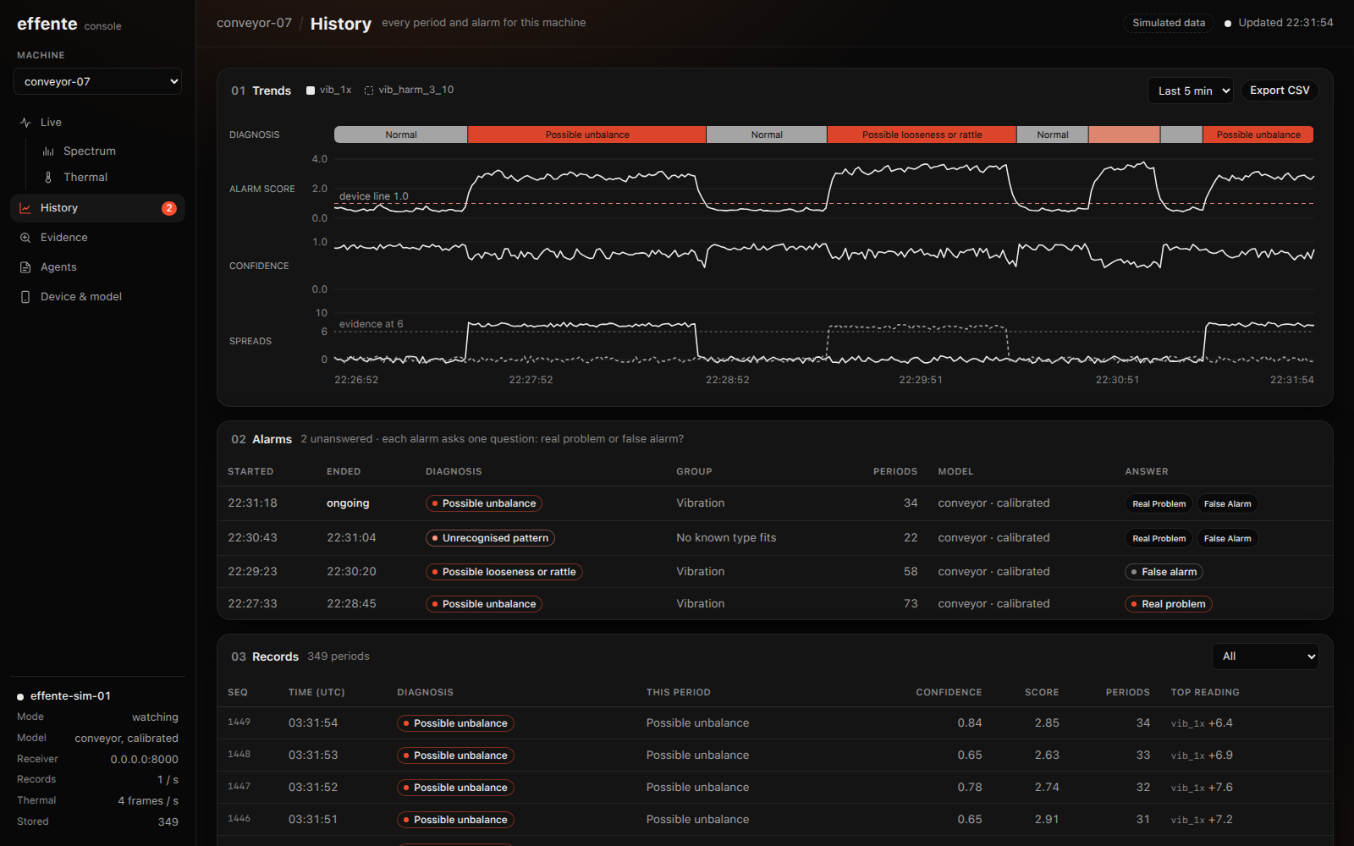
platform/desktop/reference/history.png
