jaken31/effente/platform/desktop/screenshots/e2e/09-problem-cleared.png

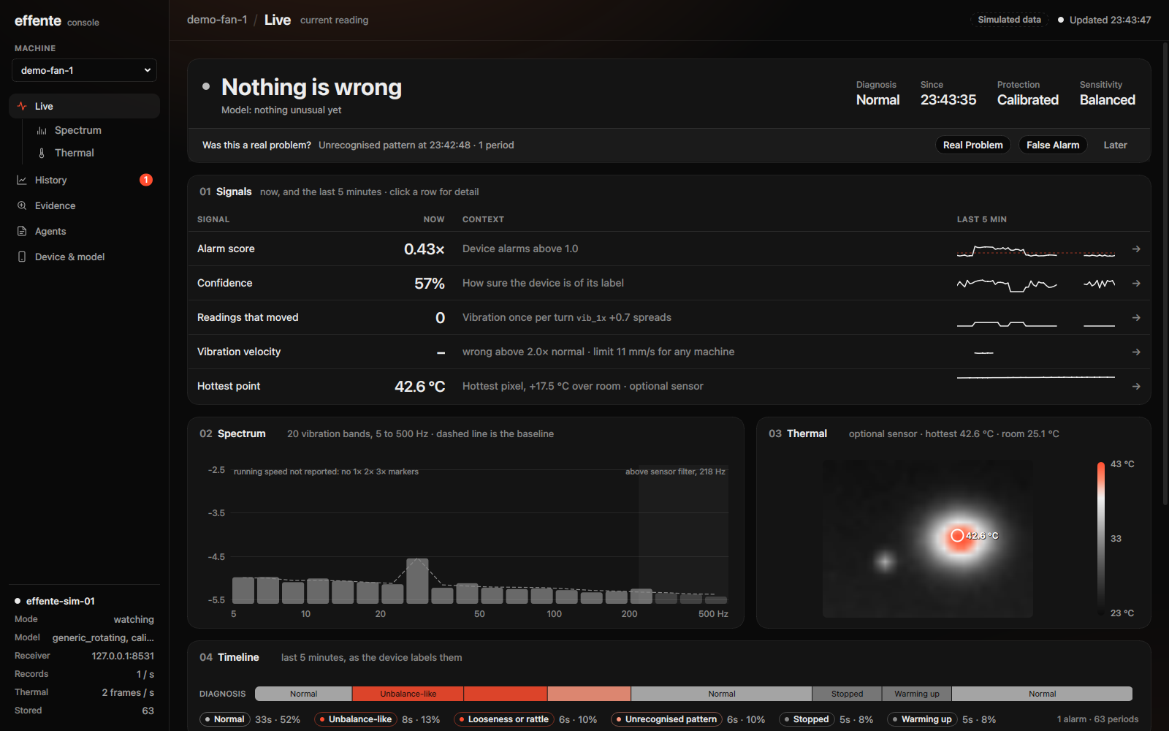
platform/desktop/screenshots/e2e/09-problem-cleared.png
