jaken31/effente/platform/desktop/screenshots/e2e/page-history.png

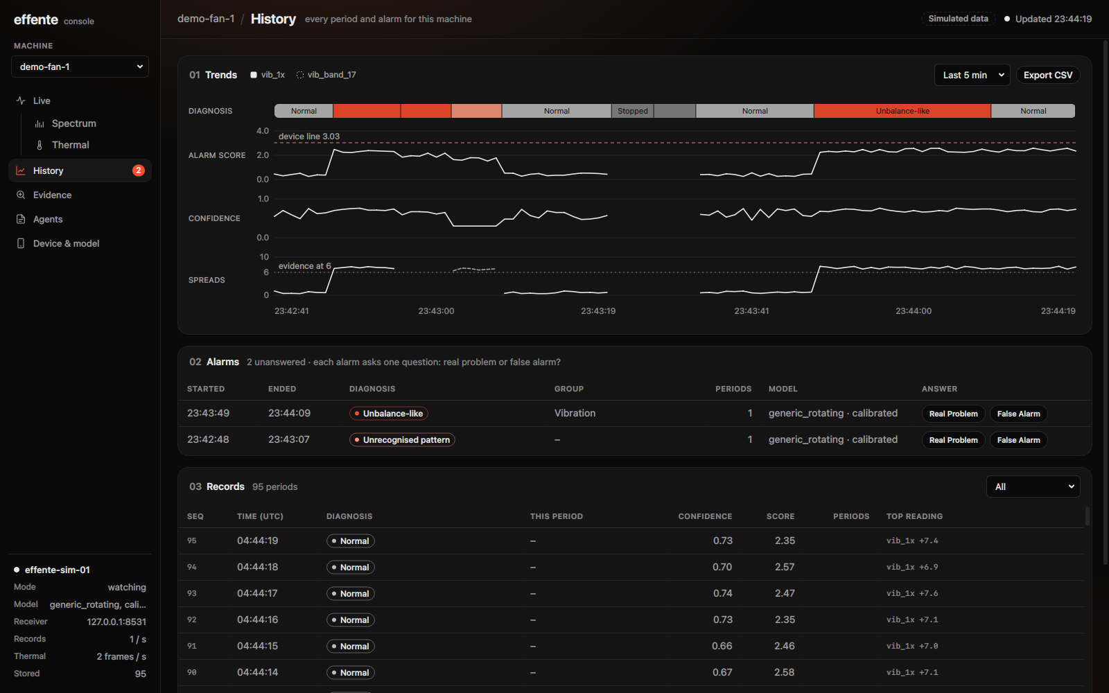
platform/desktop/screenshots/e2e/page-history.png
