jaken31/effente/platform/desktop/screenshots/live/history.png

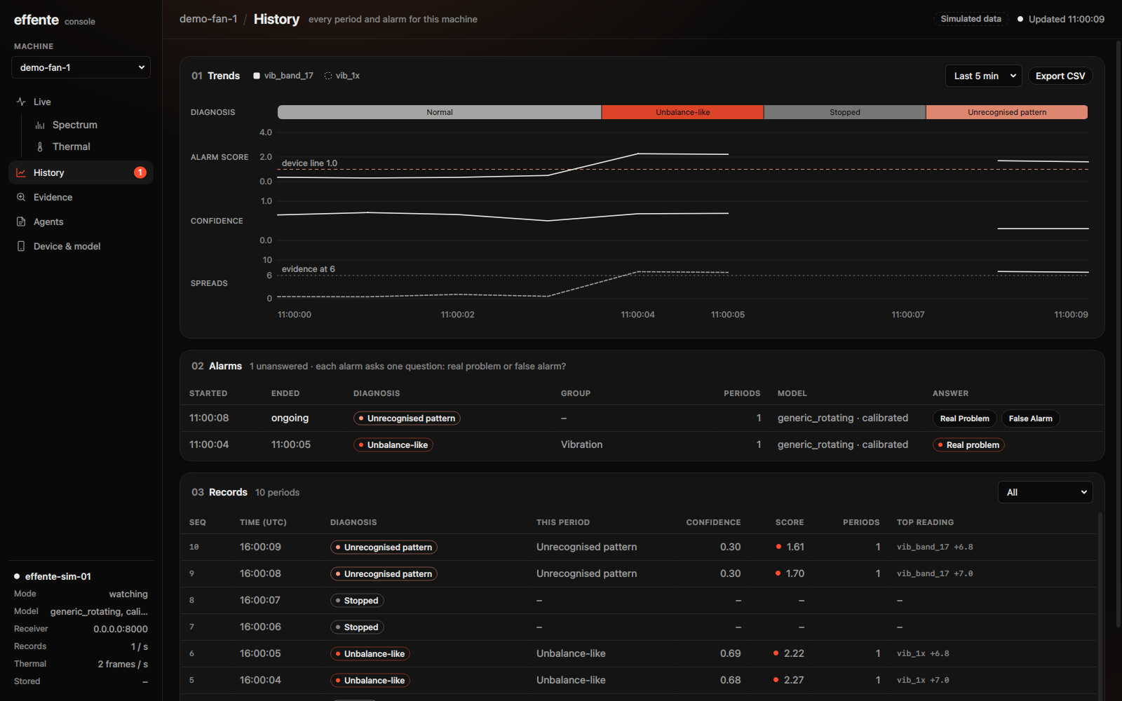
platform/desktop/screenshots/live/history.png
