jaken31/effente/(commit log)

2026-11-12 docs: expand README with project pitch, hardware, demo and build plan
2026-11-12 docs: add PRD and TRD, update README for permanent UNO Q sensor
2026-11-12 docs: drop FPGA stretch track from README, PRD and TRD
2026-11-12 docs: redesign as handheld with magnetic sensor head, add research and mock-up
    Switch README, PRD and TRD from a permanent sensor to a handheld probe.
    Add physical design and market research reports and a dimensioned mock-up.
    Apply market findings: sourced downtime figures, named buyer, handheld
    analyzer competitors.
2026-11-12 docs: add part prices, set MPU6050 as the accelerometer
2026-11-12 feat: scaffold maintenance agent harness
    Add device/agent with the report schema and checks, log and feature table
    loading, and run_agent, which calls Claude through the SDK tool runner.
    The Claude call is untested against the live API. Parts lookup is a stub.
    Add machine_id to the log record format in the TRD.
2026-11-12 docs: add device and platform contract for track 5
2026-11-12 test: add ten synthetic logs with known answers, receiver and CLI tests
    [two_machines.expected.json, wrong_machine.expected.json]
2026-11-12 feat: simulated device model with mechanical feature mask
2026-11-12 feat: simulated device main loop, keyboard, platform link and replay
2026-11-12 test: simulated device cases, masks, replay and end-to-end runs
2026-11-12 docs: simulated device README as device-side reference
2026-11-12 feat: add fake-data generator for a simulated normal day
    Adds effente/simulate_day.py to the shared effente/ package. This is an
    addition only: no existing format or pipeline changes.
    It simulates one day of normal operation (no faults) of a factory
    cooling-water pump: off, start-ups, coast-downs, loads from 50 to 95
    percent, motor warming and cooling, a daily room temperature swing, and
    harmless background events (compressor, forklifts, clangs, voices, people
    walking past, technician checks).
    Output files carry the agreed recording fields (samples, sample_rate_hz,
    label, session_id, mount_id, fan_rpm, recorded_at) plus extra fields for
    gyroscope, microphone and thermal camera data and per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
2026-11-12 Document conveyor demo parts and assembly instructions
    Added detailed parts list and instructions for building a conveyor demo, including options for purchasing or constructing the conveyor, power requirements, fault kits, and tools needed.
2026-11-12 test: add mixed session log with every case
2026-11-12 feat: shared multi-sensor feature pipeline, history and model-input preparation
    Adds three new modules to effente/ (shared code). They are additions:
    nothing on master computes features yet, so no existing behaviour changes.
    They do implement a different signal pipeline from the TRD's (FFT bins of
    the accelerometer only), so the team needs to agree before relying on it.
    - features.py: 210 per-window features from one second of data from the
    MPU6050 (vibration and gyro), INMP441 microphone, MLX90640 thermal camera
    and BME280 room sensor, plus the clock (hour and weekday as sine/cosine).
    - history.py: 68 history features from the past of the same stream:
    slow vibration, repeating knocks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
    [features.py, history.py, model_input.py]
2026-11-12 feat: simulated conveyor week and server rack for testing the intake
    Fake data only, for testing the intake before the sensors arrive.
    - simulate_conveyor.py: a belt conveyor on a shift schedule over a week,
    with a wearing idler bearing, a jam, a belt rubbing the frame and a
    damaged splice.
    - simulate_server.py: a data-center server rack over three days, with a
    UPS alarm, a rack bump, an overheating power connector, a wearing fan
    bearing, a clicking hard drive, a fan failure and a cooling failure.
    - simulate_day.py: adds the BME280 room sensor (temperature and humidity,
    1 reading a second) to the fake pump day.
    Fault signatures are modelled from the literature, not measured.
    [simulate_conveyor.py, simulate_day.py, simulate_server.py]
2026-11-12 feat: data intake: aligned windows, learn-mode recorder, watch mode, storage cleanup
    The track 2 intake for a device left beside one machine to learn its
    normal over days to a month. It lives in device/intake/ because it runs on
    the UNO Q's Linux side; track 1 owns device/, so this needs their OK too.
    - windowing.py, source.py: 1 s windows every 0.25 s, aligned by timestamp,
    with a sensor timeout; long gaps and clock jumps are skipped at once.
    - recorder.py: learn mode. One feature row a second in hour files, per-
    minute min/mean/max, raw snippets, sudden-event clips and an events log;
    a power cut loses at most a minute, and a restart continues the hour.
    - live.py: watch mode. Rows to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
2026-11-12 feat: live data stream for watch mode (--serve PORT)
    New device/intake/stream.py (standard library only): a threaded HTTP
    server that publishes watch mode's data to anyone who connects.
    - /stream: Server-Sent Events, ?topics=results,features,events,status.
    Results every window, a full feature row per second of data, recorder
    events as they happen, a status heartbeat every 5 s. 30 s replay on
    connect; Last-Event-ID resumes without repeats.
    - /latest, /features (feature table with text, units, sensor), /health.
    - CORS open. Publishing never waits: per-client bounded queue dropping
    the oldest, a client that stops reading is disconnected after 10 s,
    at most 16 clients. NaN is never wr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
2026-11-12 docs: merge mech interp into track 3
    Track 3 now owns training, the unknown alarm, the model file and all
    interpretability work (unit analysis, switch-off tests, feature table,
    mask) plus the interp/ folder. Track 4 is retired; track 5 keeps its
    number so existing track5/* branches and CONTRACT.md stay valid.
2026-11-12 feat: real-site disturbances and multi-week options for the simulators
    Fake data only. effente/site_noise.py adds what a real site has on top of
    any simulated machine: dropped tools, door slams, people talking,
    forklifts (some with reverse beepers), a neighbouring machine, someone
    knocking the device, people in front of the camera, a hot mug in view,
    sun through a window, weather drift, camera artefacts and short sensor
    dropouts. Every disturbance is labelled (nuisance_at), so false alarms
    can be counted by cause. Rates and levels are plausible starting values,
    not measured on a real site (unverified).
    The simulators get a `week` option (another week of the same machine and
    camera; week 0 i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
    [simulate_conveyor.py, simulate_server.py, site_noise.py]
2026-11-12 feat: signal pipeline: swing features, IMU temperature, faster FFTs, UNO Q source
    Changes to the shared signal pipeline in effente/ (285 features now), so
    the team needs to agree before relying on them:
    - swing features: how much heat, vibration and sound go up and down over
    10 min and 1 h (10th to 90th percentile, so one spike does not count),
    for excess temperature fluctuation and intermittent faults
    - imu_temp_c: the IMU's own temperature sensor (MPU6050/6500 TEMP_OUT);
    also the heat reading for history when there is no thermal camera
    - every FFT uses the nearest length made of 2, 3 and 5: an awkward window
    length (15,999 samples) ran 30x slower on the UNO Q. Features per window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
    [features.py, history.py, model_input.py]
2026-11-12 feat: model: autoencoder, 21 general fault types, NumPy trainer and device runtime
    training/ is track 3's folder; this is here at the user's request and
    needs their OK.
    - effente/trainer.py: trains one machine's model from its recording, NumPy
    only, so the UNO Q can train itself: a small denoising autoencoder,
    int8 weights with a scale per neuron, a gamma-fit threshold for one
    false alarm a week, and a fault-type classifier trained on fault
    patterns injected into the machine's own normal variation
    - effente/fault_types.py: 21 general fault types, the same on every
    machine, as signatures over named features (unverified, not learned
    from real labelled faults)
    - effente/model_runti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
2026-11-12 feat: turn real public datasets into effente features
    Adapters for real data (the data itself stays out of the repo):
    - NASA/IMS bearing run to failure: each snapshot as our MPU6050 would
    record it (1 kHz, its low-pass and noise), then our vibration features
    - DCASE 2024 Task 2 fan sounds (16 kHz, like our microphone): our sound
    features per clip
    Licences: IMS states none (cite the source); DCASE is CC BY-NC-SA 4.0.
2026-11-12 feat: UNO Q device app: streaming, recording, training on the board, inference
    An Arduino App Lab app (device/app). device/ is track 1's area under
    AGENTS.md; this is track 2's sensor app until theirs replaces it.
    - sketch: MPU6050/6500 FIFO at 1 kHz (accel every sample, gyro every
    10th, IMU temperature per batch) over the 115200-baud Bridge (65 % of
    the line, measured), button on D2, OLED redrawn as fast as the bus
    allows with live values drawn by the microcontroller
    - device_app.py: plug in -> STREAMING; button -> RECORDING; button ->
    TRAINING on the board; then INFERENCE. The screen shows the mode and
    the time; the live stream (device/intake/stream.py) runs throughout;
    it res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
    [sketch.ino]
2026-11-12 feat: the model slot passes each row's time to models that want it
    ModelSlot.predict(x, t0) calls the model's predict_at(t0, x) when it has
    one, so a model judging per-minute or per-second summaries (the effente
    runtime) knows when each period ends; other models keep predict(x).
2026-11-12 feat: add enclosure and conveyor CAD under device/cad
    [conveyor_belt_TPU.stl, conveyor_drive_roller.stl, conveyor_frame.stl, conveyor_idle_roller.stl, conveyor_motor_bracket.stl, device_back_shell.stl, device_front_lid.stl, device_head_lid.stl]
2026-11-12 docs: switch demo to conveyor and MPU-6500, move conveyor docs
2026-11-12 docs: add model lifecycle spec
    Library-first setup: pick a pretrained network, calibrate in minutes,
    optional long stay for a machine-specific model. Covers machine profile,
    day-0 rules, fit check, alarm feedback, learning over time, review agent,
    data plan and open questions.
2026-11-12 docs: contract version 2
    Runtime diagnosis names and fault groups, readings that moved as
    features, no feature mask, 20-band spectrum, library entry and source
    in the model announcement, device check-in, agents on the laptop.
2026-11-12 docs: reframe PRD, TRD and README around the model library
    Quick setup from a pretrained library entry is the default; a long stay
    on one machine is optional. Explanations are the readings that moved;
    switch-off tests and the explanation table are dropped. Agents run as a
    fleet on the laptop. AGENTS.md truthfulness rule updated to match.
2026-11-12 feat: safety checks with no setup, sensitivity, and week-long training from minute summaries
    Shared code: only additions, and existing behaviour is unchanged.
    - effente/safety.py (new): says only whether something is wrong, and what.
    - Universal limits work from plug-in, on any machine: vibration over 11 mm/s, knocking,
    over 100 C, heating 8 C a minute, 5 jolts in 10 minutes.
    - After training, checks against the machine's own normal: 2x vibration, +15 C, +6 dB.
    - Each must hold for 10 s. A sensitivity from 0 to 1 (default 0.5) scales the checks
    against normal and the model's line.
    - trainer: load_for_training reads a recording of a day or more from its per-minute
    medians, so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
    [model_input.py, model_runtime.py, safety.py, trainer.py]
2026-11-12 feat: device shows what is wrong in every mode; sensitivity via /settings
    - The screen shows "! ..." lines for problems in every mode.
    - Inference says NOTHING WRONG, or names what is wrong.
    - Notes appear for 2 minutes after training.
    - The stream sends problem and problem_cleared events. Status gains wrong, what and problems.
    - GET and POST /settings read and change the sensitivity (0 to 1). So does data/settings.json.
    - Tests for the checks, sensitivity, /settings and minute-summary training.
2026-11-12 docs: sync research and parts docs with the CAD and team hardware
2026-11-12 feat: add stick-on holder for an external power bank
    [device_bank_holder.stl, effente_device.f3d, effente_device.step]
2026-11-12 docs: let a person start the agent from the desktop app, never over HTTP
    The version 2 line was carried over from version 1, where the agent ran
    on the device and the platform could not reach it. With the agent on the
    laptop, the protection that matters is no network route to a paid Claude
    call. Allow the desktop app's local button, keep HTTP and the web
    dashboard out, and limit the app to one run per machine at a time.
2026-11-12 docs: add alarm feedback to the contract as version 2.1
    The platform works out alarms from stored records (no device change) and
    people answer each one as a real problem or a false alarm. Adds section 6
    (alarm definition, POST /api/alarms/{id}/answers), alarms in /api/state,
    the alarm stream event and a per-machine alarm history. Additions only;
    pending the team's sign-off. Architecture data model and the lifecycle
    doc are updated to match.
2026-11-12 docs: add sensitivity setting to contract 2.2
    Records say the sensitivity they were judged at and the alarm line
    unknown_score is compared with. The dashboard sets a wanted value; the
    device picks it up from the replies to uploads and check-ins, keeping
    the device-only-calls-out rule.
2026-11-12 feat: turn bank holder into a display-up tray, flush with the front
    [device_bank_holder.stl, effente_device.f3d, effente_device.step]
2026-11-12 refactor: rename safety check vibration_too_high to vibration_over_limit
    The universal 11 mm/s limit and the model fault type shared one name, so
    verdict() could list "vibration_too_high" twice with two meanings. The
    fault type keeps its name (model files and platform/CONTRACT.md use it).
    Safety.set_baseline maps the old name in a saved model's dropped list to
    the new one, so older models still drop the limit. Screen text becomes
    VIB OVER LIMIT, matching VIB OVER NORMAL.
    [safety.py]
2026-11-12 feat: receiver follows contract version 3: check-ins, problems, mode
    Remove the feature mask routes and state. Add POST /api/devices/{id}
    check-ins, require problems and wrong in records, keep each device's
    mode, wrong and problems in /api/state, put mode in device events, and
    make problem and problem_cleared events, clearing with "device quiet"
    when a device goes quiet.
2026-11-12 feat: cover the bank except its screen, add snap latches
    [device_bank_holder.stl, effente_device.f3d, effente_device.step]
2026-11-12 docs: contract 3.3 adds an optional heat field to records
    A record may carry the IMU temperature and, with a thermal camera, the
    heat summary and up to two 32x24 images a second. History omits the
    images unless asked.
2026-11-12 feat: receiver history leaves out heat images unless frames=1 is asked
2026-11-12 feat: simulated device sends the contract 3.3 heat field
    --heat camera|imu|none and the t key choose the source. The fake
    receiver now checks the heat field's shape.
2026-11-12 feat: dashboard dev stub sends the simulated heat field
    Uses platform/sim/sim_heat.py; /dev/heat switches the source and history
    leaves out images unless frames=1.
2026-11-12 feat: dashboard heat panel for the contract 3.3 heat field
    Plays the thermal images at 2 a second with the hottest pixel ringed,
    falls back to the 8x6 grid when a record has no images, and shows the
    IMU temperature and its trend when no camera is fitted.
2026-11-12 feat: add uploader that sends the device's data to the platform (contract 3.1)
    Standard library only, outgoing requests only. Message 1 at start, after
    training and on need_model; a record a second while watching with problems,
    wrong, reason, sensitivity and alarm_line; a check-in a second otherwise.
    Bounded queue on its own thread; newest records kept through an outage and
    sent as arrays when the platform is back. Off when EFFENTE_PLATFORM_URL is unset.
2026-11-12 feat: wire the uploader into DeviceApp and the UNO Q app
    DeviceApp announces its model at start and after training, hands every row to
    the uploader, and applies a sensitivity set on the platform through its
    existing settings path, so it is saved in data/settings.json.
2026-11-12 test: uploader against a fake contract 3.1 platform
    Record and message 1 shape, a problem while the diagnosis is normal, a
    check-in with problems while recording, need_model, an outage then catch-up,
    a platform that never answers, platform-set sensitivity surviving a restart,
    and the whole device learning, training and watching.
2026-11-12 docs: how the device sends to the laptop platform
2026-11-12 feat: simulator follows contract version 3: problems, check-ins, no mask
    Records carry the version 3 shape (runtime diagnosis names, readings in
    spreads, 20 log10 bands, problems and wrong). Problems are switched on by
    hand apart from the case and hold for about 10 s before they show, so a
    problem can be on while the model says normal or stopped. Modes other
    than watching send POST /api/devices/{id} check-ins with limits only.
    The feature mask is gone. Replay keeps the spacing of a file's times.
2026-11-12 fix: dev stub reads every request body before replying
    A PUT refused before its body was read (unknown device, unknown route)
    left the body on the keep-alive connection, where it was parsed as the
    next request. That request got a 400, and the error reply to the closed
    socket printed a BrokenPipe traceback in every web test run.
2026-11-12 fix: receiver reads the body of requests it refuses
    404 and 405 replies left the body on the keep-alive connection, so the
    next request on it got a 400. A contract 3 device's check-in (POST
    /api/devices/{id}) hits that 404 today.
2026-11-12 feat: dashboard follows contract version 3: problems next to the diagnosis
    The headline is the device's wrong, in every mode, and says Not live
    rather than Nothing is wrong when the device or platform is not live.
    Under it the model's panel (Model: nothing unusual yet while normal,
    stopped and warming up never hidden, unvalidated fault types marked
    possible), then each problem with its value and kind label. The mask UI
    is gone; readings that moved use the announced text and show spreads;
    the spectrum uses the 20 announced band edges; history adds a problem
    strip and the unknown score against its alarm line.
    dev_stub.py now runs the real receiver fed by a scripted simulated
    device, so it can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
2026-11-12 fix: say "1 reading", not "1 readings", in the out-of-range note
    [model_runtime.py]
2026-11-12 chore: list numpy and scipy in device requirements for the intake tests
2026-11-12 fix: UNO Q sketch reads clean MPU data again after the board was reflashed
    On 12 Nov, after the reflash, the device read 0.1-2.2 g of gravity and up to 2 g of vibration at rest.
    - Drawing the whole screen at once held the bus for about 27 ms, which overflowed the MPU-6500's
    512-byte FIFO and put every later sample out of step.
    - The overflow check assumed the MPU-6050's 1,024 bytes, so it never caught it.
    The fixes:
    - The screen draws one page per pass, at 10 frames a second, with the bus at 400 kHz.
    - The FIFO limit follows WHO_AM_I.
    - A failed read resets the FIFO instead of carrying on out of step.
    - The 5 s status goes out as one Monitor message instead of twenty.
    - The bar uses its o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
    [sketch.ino]
2026-11-12 feat: say what is going on in plain words, and catch a sensor whose readings make no sense
    Shared code: these are additions. Watcher states gain "symptom" and "symptoms". The verdict's "what"
    now holds plain descriptions; the specific names move to "details".
    - fault_types: SYMPTOM_TEXT and describe().
    - describe() works straight from which groups of readings left normal: vibration level, shape,
    spikiness, speed, temperature, sound, and so on.
    - Two guards: no "speed changed" when the vibration's shape changed broadly, and no "device moved"
    when the vibration rose or clipped.
    - On 20 real bearings (Ottawa) it described all 35 caught faults accurately. Naming the cause was
    r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
    [fault_types.py, model_runtime.py, safety.py]
2026-11-12 feat: results follow the platform contract, a guided fan test, and the device app shows symptoms
    - Results lines and status carry the contract's required fields, such as model_version and reason.
    - Our detailed diagnosis is mapped onto the contract's values and kept as diagnosis_detail.
    - wrong, what, details and problems pass through.
    - CONTRACT_NOTES.md lists what the contract can't yet express, for track 5.
    - device/app/fan_test.py guides the real fan test: learn, train, watch, tape a coin, report.
    - It passes when there are no false alarms and the coin is described as a vibration problem.
    - DeviceApp shows the plain descriptions on the screen, and SENSOR PROBLEM first when it's o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
2026-11-12 feat: measure detection and descriptions on real bearing faults (University of Ottawa)
    20 bearings, each healthy, then developing, then full fault.
    - Each bearing's normal is learned from 6 s of healthy data, as the device would see it (1 kHz MPU).
    - At the default sensitivity it caught 35 of 40 faults and flagged none of the 20 healthy bearings.
    - It described all 35 accurately, but named the cause right once.
    - Results and limits are in OTTAWA_RESULTS.md.
2026-11-12 docs: contract note for track 5: the dashboard and the screen describe faults differently
2026-11-13 docs: move self-adjusting conveyor doc to docs/research and fix its images
2026-11-13 feat: simulated device takes the sensitivity from platform replies (contract section 7)
2026-11-13 docs: describe how the simulated device uses sensitivity
2026-11-13 fix: maintenance agent reads contract 3.3 records (null unknown_score, v3 diagnosis names, readings in spreads)
    [report.py]
2026-11-13 test: convert agent test logs to contract 3.3 and add a simulated session with stopped and warming up
    [two_machines.expected.json]
2026-11-13 feat: FakeState for page tests, with the logic port and state reads it needs
    FakeState holds what a real Receiver and the stand-in agent return for
    platform/sim/sample_replay.jsonl. logic.py ports dashboard_logic.js and adds
    the laptop-only alarm and sensitivity helpers; tests follow.
2026-11-13 test: logic.py against every dashboard_logic.js case, and JS/Python parity on shared inputs
    Each JS test has a named Python port, and a check fails when the JS file
    gains a test without one. A node runner feeds the same hand-picked and
    random event sequences through both and compares every answer.
2026-11-13 feat: thermal page with camera image, heat trend and cell grid
2026-11-13 feat: desktop Device & model page: devices, model, event log with pause
2026-11-13 test: Evidence, Agents and Device & model pages on FakeState
2026-11-13 docs: 1600x1000 screenshots of the Evidence, Agents and Device & model pages
2026-11-13 fix: band chart filter label no longer clipped to the shaded area
2026-11-13 fix: thermal page fonts, IMU note in the trend, no -0.0, empty state without scrollbars
2026-11-13 feat: evidence threshold and fault type tag in logic.py
    EVIDENCE_SPREADS and is_evidence follow docs/TRD.md and device/agent/report.py;
    fault_type_tag marks unvalidated types as possible (contract section 1).
    Laptop only: dashboard_logic.js has neither.
2026-11-13 feat: ReceiverHost runs the receiver and simulated device in the app's process
    Uses Receiver.start/stop and Sim.run(keys) as they are; a key queue stands in
    for the terminal so the app can press the sim's keys and quit it.
2026-11-13 feat: ApiClient for the dashboard's routes and a reconnecting stream reader
    The reader reads GET /api/state after every (re)connect, as the contract
    says, and hands events to the Qt thread through queued signals.
2026-11-13 fix: shell reads DashboardState freshness status, device_id and stored_count
2026-11-13 test: in-process sim with keys and sensitivity, and stand-in agent runs through report.py
    The agent test runs a copy of platform/report.py over a temp data folder with
    the real device/agent beside it, so it needs no network and leaves
    platform/server/data alone.
2026-11-13 fix: long device card values end in an ellipsis instead of overflowing
2026-11-13 feat: desktop Live page
    Status card with the contract headline, the model line, problems, meta tiles
    and the alarm question; signals table with FlagValue and sparklines; spectrum
    and thermal previews on agent 4's widgets; timeline band; events; controls
    with per-device sensitivity, report agent, bookmark, export and sim keys.
    [common.py]
2026-11-13 feat: desktop History page
    Trends (diagnosis band, alarm score with the device and wanted lines,
    confidence, spreads with evidence at 6) with a range select and CSV export,
    alarms with answer buttons or the recorded answer, and filtered records.
2026-11-13 feat: stored record count on the device card, read from the embedded receiver
2026-11-13 fix: band chart top notes share the line without overlapping
    The speed note takes the room left of the filter note, elided, and is
    dropped when too little is left.
2026-11-13 fix: Live and History use logic's evidence rule and the shell's panel headers
    Drop the header workarounds now that Panel keeps hint-less titles left and
    grows with its controls. Pages report their natural height as their minimum,
    so the shell's scroll area scrolls them instead of squeezing panel headers.
    [common.py]
2026-11-13 feat: realistic industrial conveyor simulator and the data to compare normal models
    Shared code: these are additions. The old (non-realistic) simulator mode is unchanged, and its tests pass.
    - simulate_conveyor: realistic mode, ConveyorSim(realistic=True).
    - The device is fixed to the drive housing, with the camera and mic pointed at the drive.
    - The sensors behave like ours: MPU-6500 noise, range and temperature steps; MLX90640 noise and offset;
    INMP441 level. There's no room sensor.
    - Healthy levels match published figures, with sources in REALISM.md: about 2 mm/s drive vibration,
    a 40-50 C motor frame, 70-85 dB.
    - Healthy vibration wanders realistically (about 17 % typical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
    [simulate_conveyor.py, site_noise.py]
2026-11-13 feat: PCA as the device's default normal model, scored by residual and Hotelling T2
    - On 20 real bearings (Ottawa), PCA caught 38 of 40 faults and flagged none of the 20 healthy bearings.
    The trained autoencoder caught 35, and PCA tied on the simulated conveyor. It also trains in milliseconds.
    - It's stored as a linear autoencoder, so the model file format and the device runtime are unchanged.
    New optional keys: "normal_model" and "pca_score".
    - Scored two ways: the residual, plus distance along the patterns (Hotelling T2). The residual alone missed
    a temperature swing that moved along a pattern of normal.
    - train_model(normal_model="autoencoder") keeps the old model.
    - compare_ottawa.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
    [model_runtime.py, trainer.py]
2026-11-13 feat: early warning for small, lasting changes before the alarm line
    - A CUSUM per group of readings, against the machine's learned normal. Alternatives (EWMA, trend,
    a CUSUM on the score, a lower line) are compared in early_warning_eval.py.
    - It never counts as wrong itself, and it steps aside when the real alarm fires.
    [early_warning.py]
2026-11-13 feat: device screen design B, MPU-6500 temperature fix, and restarts that recover by themselves
    - Screen, design B: a header plus four large tiles (vibration, peak, temperature in F, speed).
    - When something is wrong, the header is inverted and names it, and the matching tile is inverted too.
    - Whole numbers, about 0.8 s smoothing. Only changed strips are redrawn, so it updates as fast as the bus allows.
    - The shown vibration is measured within each frame, with no slow gravity estimate, so it drops at once.
    - Temperature: the MPU-6500's conversion (raw/333.87 + 21) replaces the MPU-6050's (raw/340 + 36.53).
    The old one read about 15 C too high. The formula is chosen from WHO_AM_I.
    -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
    [sketch.ino]
2026-11-13 fix: screen never inverts: no white header or tile when something is wrong
    The header still names what is wrong; the tile key is still sent but no longer drawn differently.
    [sketch.ino]
2026-11-13 fix: spectrum drops band edges when the machine has no model
    Switching to a machine with no announced model kept the previous
    machine's Hz labels, because a None model left the old edges in place.
2026-11-13 fix: the button is on D9, as the board is wired
    [sketch.ino]
2026-11-13 fix: History marks unvalidated faults as possible
    Alarm and record rows showed a fault the model announced with
    validated: false as a plain diagnosis. They now read "<name> · possible"
    in a muted pill with the "possible · not validated" tag as tooltip, as
    contract section 1 asks. A fault from a different model version is
    treated as unvalidated, since its validation is not known.
    [common.py]
2026-11-13 fix: History trends read the whole range from the receiver
    "Last 1 h" and "All" filtered the 300-record live cache, so any session
    over five minutes was cut off. History now asks the state for a range;
    the state pages through GET /records with since and after_seq (PR #30),
    keeps streamed records in it, and falls back to the live cache with a
    notice if the read fails. INTERFACES.md lists the additions.
2026-11-13 feat: colour scheme setting for the desktop app
    A Colours picker in the sidebar chooses between Red apple (default), Amber,
    Blue and Light. The choice is saved with QSettings and applied at the next
    start; --scheme overrides it for one run.
    Colours that were hardcoded outside the tokens (disabled buttons, page glows,
    chart overlays, the select arrow) are now tokens so a scheme can replace them.
    The thermal ramp keeps its fixed gray-white-red colours in every scheme.
2026-11-13 feat: model library layout, sources and the entry build script
    training/library/build.py builds a library entry from a declared list of
    sources (training/library/catalog.py) into entries/<entry_id>/model.json
    and manifest.json. model.json is a plain effente-model-1 file from
    effente.trainer.train_model; nothing in effente/ is changed.
    - Several machines: each machine's rows are re-expressed with its own
    Prep median and spread on the first source's scale, then pooled, since
    calibration refits Prep per machine and keeps only the network.
    - Held-out score quantiles come from the trainer's own split by time.
    - Only MPU-6500 sources may train an entry (the TRD rule); the build
    refuses anyt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
2026-11-13 feat: generic_rotating and conveyor library entries
    Built with: python3 -m training.library.build --seed 0 (commit cc9e87e).
    Simulated data only, nothing verified on a real machine.
    - generic_rotating 0.1.0, status unverified: six simulated drives that
    differ in speed, load and mount. model.json 143,404 bytes.
    - conveyor 0.1.0, status demo: the conveyor simulator alone.
    model.json 143,385 bytes.
    - Every fault type in both scorecards is 'not validated': no simulated
    fault raised an alarm against the entries' own thresholds.
    - Public sets and the MPU6050-modelled pump simulator are listed as
    evaluation only; no evaluation was run.
2026-11-13 test: model library build, sources and committed entries
    Run with: python3 -m training.library.tests.test_library
    Covers: byte-identical rebuilds for a seed, every model.json loads in
    model_runtime.Model, every manifest field, the reported file size, the
    held-out split is the trainer's (proved through its threshold), pooled
    rows keep each machine's own normal, only MPU-6500 sources may train,
    and a device recording can replace the simulator.
2026-11-13 feat: calibrate a library entry to one machine, with a fit check
    New file effente/calibration.py (shared code, addition only: no existing
    function or format changes). Keeps the entry's network; fits Prep levels,
    residual spreads, threshold, fault classifier and baseline to the machine.
    Laptop CLI, simulated measurement script and tests under training/calibration/.
    Work in progress: measured numbers and docs follow.
2026-11-13 feat: calibration uses the entry as guard, and reads the library's entries
    effente/calibration.py only (new file; no existing code changed).
    - spreads: widened by the entry's calibration.widen, or never below the
    entry's own; readings the entry holds or the machine lacks are not judged
    - threshold: fitted here, never below the entry's
    - fault classifier: fitted only for an entry that carries one
    - fit check reads fit_check.entry_heldout_score_median from the manifest
    measure.py now takes library entry folders (--entry).
2026-11-13 feat: check a report's shape, named readings and numbers
    check_report now applies three more checks to every report:
    - shape: the five keys, their types, nothing extra. The API no longer
    enforces the schema, so the code does.
    - the summary and recommended action name no reading that is not cited,
    unless it was switched off in some window.
    - every number in the summary and recommended action appears in the
    readings the agent was given.
    [report.py]
2026-11-13 docs: calibration README with the simulated measurements; keep the entry's period
    effente/calibration.py (new file only): the entry's summary period is kept
    when the calibration is long enough for it. All numbers in the README are
    simulated and unverified on real machines.
2026-11-13 feat: desktop window shrinks to 960x660
    The window refused to go below 1440x900, so it could not sit beside a
    terminal or fit a small laptop screen. It now opens at 1440x900 and
    shrinks to 960x660. In a narrow window the top bar drops the subtitle
    so the machine, page name and freshness are never cut; pages narrower
    than their content scroll sideways.
2026-11-13 feat: desktop app opens where the last run closed
    Only the colour scheme was kept between runs. The window now also
    remembers its size, the page and the machine picked by hand. A machine
    that is gone the first time the list is known is dropped rather than
    switched to later. All of it sits in one settings store (app/settings.py),
    which the colour scheme now uses too.
2026-11-13 feat: keyboard shortcuts for the desktop app, listed by ?
    Only the page keys 1 to 7 existed. Adds Esc (back to Live), [ and ]
    (previous and next machine), Ctrl+R (run the report agent), Ctrl+E
    (export CSV on Live and History), F11 (full screen), ? or F1 (a card
    listing the shortcuts) and Ctrl+Q. One table registers the keys and
    fills the card. The pages' export dialogs are now public so the window
    can call them.
2026-11-13 feat: launcher entry and icon for the desktop app
    The app started only from a terminal. install_launcher.py writes a
    desktop entry and icon under ~/.local/share so it opens from the app
    launcher (Linux), with an action for a real device (--no-sim). The app
    sets its window icon and desktop file name to match. A receiver that
    fails to start now also shows a dialog, since a launcher start has no
    terminal to print to.
2026-11-13 feat: Ctrl+K search in the desktop app
    A card with a search field that finds pages, the other machines and
    the window's actions as you type. Arrows move the choice, Enter or a
    click runs it, Esc or Ctrl+K closes it. It is in the shortcut list.
2026-11-13 docs: add log in flow and user onboarding to track 5's stretch work
2026-11-13 docs: PRD says nothing leaves the site and the agents run on a local model
    The edge for companies with secret data is that no cloud provider or outside
    service sees machine data. Requirements, demo script and competitors now say
    so: agents run on a language model on the laptop (P8, P9, new P9a), parts
    lookup moves to the roadmap as an opt-in, and picking an entry in the laptop
    app is a should-have (P1b). Three open questions record what simulated runs
    showed and what is still unmeasured: the calibration rule and length, the fit
    check, and local model quality.
2026-11-13 fix: entry's period, fit check wording, threshold floor as a parameter
    effente/calibration.py only in shared code (a file this branch added; no
    existing function changes).
    - summaries use the entry's own period
    - threshold_floor_share (keyword, after seed, default 1.0 = as before)
    - a fit check pass is worded as no gross mismatch, never as proof of type;
    constants marked starting value, simulated only
    - tests: the library manifest's heldout_score_quantiles keys, floor shares
    0, 0.5 and 1, the entry's period
    measure.py: --threshold-floor-share, --faults-only, reports the fitted threshold.
    [calibration.py]
2026-11-13 docs: TRD matches the local agents and what simulated calibration runs showed
    Agent fleet and harness: the model is served on the laptop (llama-server,
    OpenAI-style routes), no tool loop, four checks in code, one retry, stand-in
    as the fallback. Claude and Tavily are gone from the architecture.
    Library and calibration: marked as in review and simulator-only. Entries are
    built on accelerometer and gyro readings over a long recording. Calibration
    keeps the entry's spread as a floor and does not refit the alarm threshold
    freely; the threshold rule is still being measured. Starting length is 10
    minutes. The fit check does not prove machine type.
    Model: PCA is the default normal model, as in ef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
2026-11-13 docs: library entry layout and calibration interface in the TRD's shared formats
    Two sessions built the library with different manifests and four built
    calibration with different signatures, because the agreed interface lived only
    in chat. It is now written where shared formats belong. Marked as in review:
    neither is on master yet.
2026-11-13 feat: bake-off script to compare local models on the agent's test logs
    Runs every test log with an expected result through the local backend
    several times. Records per run whether the report passed first try, after
    the retry, or failed, with reasons, seconds, and every report in full.
    Writes one JSON file and prints one table. Not yet run against a real
    model server.
2026-11-13 feat: report.py takes --backend and --llm-url in place of --live
    The agent now runs on a model server on this laptop. report.py passes
    --backend {local,standin} (default local, as device.agent) and --llm-url
    through. The desktop app names the backend on every run.
2026-11-13 docs: the two floors are deliberate, what they cost, and known issues
    Docstring of effente/calibration.py (a file this branch added) and the
    calibration README. All numbers simulated, unverified on real machines.
    [calibration.py]
2026-11-13 feat: default threshold floor share 0.25
    effente/calibration.py (a file this branch added; no existing function
    changes). threshold = max(fitted, 0.25 x the entry's threshold). A starting
    value, simulated only, tied to the entry's threshold. Tests keep shares 0,
    0.5 and 1 and check the new default.
2026-11-13 docs: what the 0.25 threshold floor share does on the simulators
    Measured at 0.25 on both conveyor entries: where it is better than 1 and
    where it is worse. All numbers simulated, unverified on real machines.
2026-11-13 feat: fit measured MPU board and OLED, enlarge button snap lips
    [device_front_lid.stl, device_head_lid.stl, device_imu_cradle.stl, device_screen_tray.stl, device_sensor_head.stl, effente_device.f3d, effente_device.step]
2026-11-13 feat: library sources on the accelerometer, gyro and IMU temperature only
    Entries were 220 columns and 143 kB against a target of about 50 kB, and the
    sound and heat of site disturbances set the threshold too high for a
    simulated fault to alarm. Simulated sources now drop the microphone, thermal
    camera and room sensor.
    Sources are watched for days, not 30 minutes: conveyor two days, each
    generic_rotating machine one day. The server rack simulator is added as an
    evaluation-only source, the wrong machine for the fit check; its
    accelerometer noise is not the MPU-6500's, so it may not train an entry.
2026-11-13 feat: manifest gains the model sha1, calibration notes and evaluated flags
    - model_sha1, and training/library/load.py: load_entry refuses a model file
    that is not the one the manifest describes or is on another feature list.
    - calibration: the hold list, per-reading widen factors, and what the model
    file's own Prep and threshold stand for. The model file gets no new key.
    - every evaluation source says "evaluated": false: the build runs none.
2026-11-13 test: library sensors, server rack, widen factors, load_entry and the new manifest fields
2026-11-13 feat: manifest says the widen factors are recorded only
    Calibration does not read them: on simulated conveyors they gave more false
    alarms than keeping the entry's own spreads as the floor.
2026-11-13 feat: rebuild generic_rotating and conveyor on days of IMU-only simulated running
    conveyor: one simulated conveyor, 48 hours, 53 kB. generic_rotating: six
    simulated drives, 24 hours each, 58 kB. Built from d52e001 with seed 0.
    Every fault type is still "not validated".
2026-11-13 docs: model library README for the IMU-only entries, training length and calibration results
2026-11-13 docs: TRD manifest table gains model_sha1, calibration and source flags
2026-11-13 test: calibrate, fit check and the CLI on the committed conveyor entry
    Checks that no widen factor is applied to a library entry (its factors are
    in the manifest, which calibrate never reads): the entry's spreads are the floor.
2026-11-13 docs: calibration measured on the library's merged entries
    effente/calibration.py: docstrings and comments only. README numbers are now
    those of training/library/entries (simulated, unverified); results on the two
    superseded entries are kept under a heading that says so.
2026-11-13 feat: macOS launcher for the desktop app
    install_launcher.py only wrote a Linux desktop entry. On macOS it now
    writes two apps into ~/Applications, effente and effente (real device)
    (--no-sim), each a shell script that starts main.py with the installing
    shell's PATH and logs to ~/Library/Logs/effente.log. The icon is drawn
    from effente.svg with PySide6 and iconutil. The Linux path is unchanged.
2026-11-13 feat: measure.py can watch a calibrated entry for a day, with or without the manifest's hold
    Measurement only: calibrate and the library's entries are not changed.
2026-11-13 feat: threshold from this machine's own held-out median, times a named multiple
    changes). threshold = THRESHOLD_MEDIAN_MULTIPLE (5.0, provisional) x the
    median of the held-out scores, smoothed as the Watcher smooths. No gamma fit,
    no floor or ceiling from the entry; threshold_floor_share is removed.
    Refuses when the held-out rows are fewer than the smoothing window or their
    median is zero or not a number. Messages and CLI help ask for 10 minutes;
    300 s stays the hard minimum. measure.py: --threshold-median-multiple and
    --calibration-s.
    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
2026-11-13 feat: add snap clips that clamp the sensor head lid
    [device_head_lid.stl, device_sensor_head.stl, effente_device.f3d, effente_device.step]
2026-11-13 feat: dock the sensor head on a magnet instead of a steel disc
    [device_front_lid.stl, effente_device.f3d, effente_device.step]
2026-11-13 fix: size the bank holder for the measured power bank
    [device_bank_holder.stl, effente_device.f3d, effente_device.step]
2026-11-13 feat: microphone and thermal camera slots; recording never resumes by itself after a power cut
    Slots only (unverified: no sketch sends audio or thermal yet), off unless EFFENTE_MIC=1 / EFFENTE_THERMAL=1. After a power cut a recording stops and the app comes back not recording; training carries on. The heartbeat also carries screen errors and frames.
2026-11-13 fix: sketch sets the sensor up again when samples stop; button on D9
    A bus glitch reset the MPU-6500 while it still answered, so samples stopped for good (13 Nov, on the board). No sample for 0.5 s now re-initialises it. Not yet tried against a real glitch. README: sensor slots, power-cut behaviour, the reset note.
    [sketch.ino]
2026-11-13 docs: the sensor-reset recovery in the device app README
2026-11-13 feat: animate the desktop app's chrome
    Adds app/widgets/motion.py: the durations, an off switch and the shared
    moves. Nav hover and selection ease, the segmented ring slides, pages
    crossfade, notices and the search and shortcut cards fade, a linked
    panel's arrow fades, and the freshness dot beats once for each record.
    Readings are never eased between values. Motion is off on the offscreen
    platform and with EFFENTE_REDUCE_MOTION or --no-motion.
2026-11-13 fix: make the page fade visible and restore the panel arrow
    The crossfade ran, but at 160ms with an ease-out it was nearly gone in
    50ms. It now takes 320ms at an even pace and starts its clock at the
    first frame. Hovering a linked panel raised AttributeError: set_arrow
    was never added to the title.
2026-11-13 fix: remove the page change animation
    Pages switch at once again. The other motion (nav, segmented ring,
    notices, search, panel arrow, freshness dot) stays.
2026-11-14 feat: ESP32-S3 microphone front end (test version)
    Reads the INMP441 over I2S and sends a text line 4 times a second on its UART: level, peak, a rough strongest tone. New folder firmware/esp32_mic. Run on the hardware 13 Nov; the level is not calibrated.
2026-11-14 feat: microphone reading on the OLED, six equal tiles
    The sketch reads the ESP32's lines on Serial1 (D0/D1) and shows sound level (dBFS + 120, unverified) and tone beside the IMU readings: six tiles, three across. The heartbeat reports mic line count and level. Screen only: nothing reaches the Linux side as a feature. Run on the board 13 Nov: 4 lines a second, IMU still at about 1 kHz; the screen's look was not checked by me.
2026-11-14 feat: read a real device from its own port (platform/link, --device URL)
2026-11-14 feat: show a device's own readings, spectrum and heat while it is not watching
    Adds an optional, proposed 'readings' field to check-ins and records in
    platform/CONTRACT.md (not yet agreed by the team). Only platform/link sends it.
2026-11-14 feat: validation harness core: simulated sessions, device judgement, result files
    track3.py is the only module that imports track 3's library and calibration.
2026-11-14 docs: validation results, REPORT.md and what to rerun with device recordings
2026-11-14 refactor: validation harness reads the merged library and track3/calibration
    track3.py now loads entries with training/library/load.py and calibrates with
    effente.calibration from PR 42. The fit check uses track 3's own rule
    (FIT_MAX_RATIO) in place of the harness's placeholder, and the training seeds
    come from the library's catalog.
2026-11-14 docs: validation results rerun on the merged library and track3/calibration
    All seven checks, seeds 1 to 5. Simulated data and the public NASA IMS set
    only; nothing from a device recording.
2026-11-14 fix: hold out the last 15 % of the running rows, not of the clock time
    A stop in the middle of a calibration left the fit side with a handful of rows (20 s run, 2 h
    stop, 580 s run fitted on 20 rows; a stop after the first row fitted on 1). The split now counts
    running rows. Without a gap it is the same split as before.
    [calibration.py]
2026-11-14 fix: refuse to calibrate when no reading the entry uses was measured
    A dead sensor (every reading NaN) gave a model in which every reading was not judged, so nothing
    could alarm. calibrate now raises ValueError below MIN_READINGS (1) judged readings.
    [calibration.py]
2026-11-14 fix: refuse to calibrate a model that is already calibrated
    Its not-judged readings carry the huge spread as if it were the entry's, so a second calibration
    kept them unjudged for good and reported nothing missing.
    [calibration.py]
2026-11-14 fix: calibrate checks its times, min_running_s and the multiple's type
    A NaN time gave "too many values to unpack" or, on a 10 s period, a fit on one garbage row; a
    NaN min_running_s skipped the length check; a NumPy float as the multiple was refused.
    [calibration.py]
2026-11-14 fix: a model-carried widen is read by reading name, as the library writes it
    calibrate wanted one factor per column in a list; the committed manifests store a dict by
    reading name, which raised TypeError, and a string hold silently held nothing. The dict is now
    the one accepted shape; anything else raises ValueError. No entry on master carries the key in
    its model file, so nothing merged changes behaviour.
    [calibration.py]
2026-11-14 fix: fit_check does not pass a held-out median of 0 or below
    Such a report is now "not checked" (ok False). Also drops the fit_check.entry_heldout_score_median
    manifest key: no manifest on master carries it (they have heldout_score_quantiles.p50), and the
    comment claimed otherwise.
    [calibration.py]
2026-11-14 fix: test names and exit codes that say what the tests check
    A reading the machine lacks is not judged (it does not keep the entry's spread), so the test's
    name now says so. The laptop command on the committed conveyor entry must exit 0, not 0 or 2.
2026-11-14 feat: measure.py can run every sudden simulated fault on every machine, with summary lines
    --all-faults: section 3 runs the conveyor simulator's 11 sudden fault kinds (obvious and subtle)
    on the 4 conveyors and the server rack's 4 on the 3 racks, and counts per entry how many alarm
    with no alarm before the fault. Sections 1 and 3 end with one summary line per entry, so a sweep
    of --threshold-median-multiple can be compared. Without the flag section 3 runs as before.
2026-11-14 docs: the threshold multiple stays 5.0, a starting value from a simulated sweep
    Swept 2, 3, 4, 5, 7 and 10 on the simulators (training/calibration/README.md). Below 5 the alarm
    seconds over a simulated day multiply; above 5 the generic_rotating entry misses faults it
    catches at 5. No value did both well. The value is unchanged; the PROVISIONAL / placeholder
    wording is replaced. Simulated only, unverified.
    [calibration.py]
2026-11-14 docs: calibration README rewritten for the median-multiple threshold, with the sweep
    Removes the floor-share rule and its numbers. Adds the sweep of the multiple with its command and
    seeds, fresh numbers at 5.0 (40 minutes, calibration length, faults by kind, 24 hours), what
    calibrate refuses, the row-count split, the widen and hold shapes, and that a 600 s calibration
    leaves the same 17 readings not judged. All simulated.
2026-11-14 docs: validation results rerun on track3/calibration a3028c0
    No number moved; only the result files' timestamps changed.
2026-11-14 docs: TRD matches the calibration threshold rule in PR 42
    The threshold is the machine's own held-out median times a multiple (5.0),
    no longer held at or floored by the entry's. Adds the multiple to the
    calibrate signature and says late trend readings are not judged.
2026-11-14 docs: add work plan for the phone scan and the part log
    Instructions for three people working in parallel: the shared interface
    (proposed as contract version 3.4), a brief per person, gates, what to cut,
    and what was and was not checked. Adds no code.
2026-11-14 chore: sort imports in the receiver wiring test
2026-11-14 feat: desktop pages machine and log, state.scans and state.log stubs, fakes with sample data
2026-11-14 docs: track 6, stretch rows for the scan and the part log, desktop interface additions 17 to 21
2026-11-14 feat: part review agent with the rule-based stand-in (J4, contract 8.8)
    platform/part_review.py runs one review per part from that part's own
    history, checks it in code and posts it as message 4 with agent part_review.
    The code fills how and since. Reuses device/agent's Run, errors and agent log
    writer unchanged. Developed against fixed history files: the parts and log
    routes are still stubs.
    [history.py]
2026-11-14 feat: desktop Log page, built against FakeLog
    Page key log: the parts list with each part's state, the entry table with a
    kind filter, an add-entry row, alarms waiting for a part with their suspects
    marked possible, the review panel, and CSV export through Ctrl+E.
    Nothing is added to the log without a person's click: Agree on a review only
    fills the add-entry row. nothing_found reads Nothing found, and says it does
    not mean healthy. The page meets the Machine page only through state.log's
    selection.
2026-11-14 fix: Log page keeps a clicked row alive, fits its columns, holds its headers still
    A list row was deleted while still handling the click that replaced the list.
    The old list is now deleted later. Column widths fit their longest values at
    1600x1000, and header buttons keep their place when hidden.
2026-11-14 feat: part review on a local model, opt-in (J4)
    --backend local asks the model server on this laptop through device/agent's
    LocalCall, unchanged, with one retry on a failed check. Run once against a
    real model on the five fixed histories: all five passed the checks. The
    result and what a reader would still fault are in the README.
